djibril99/stageIRD/images/TEST_Filtre_mediant_passBas/provessus.jpg

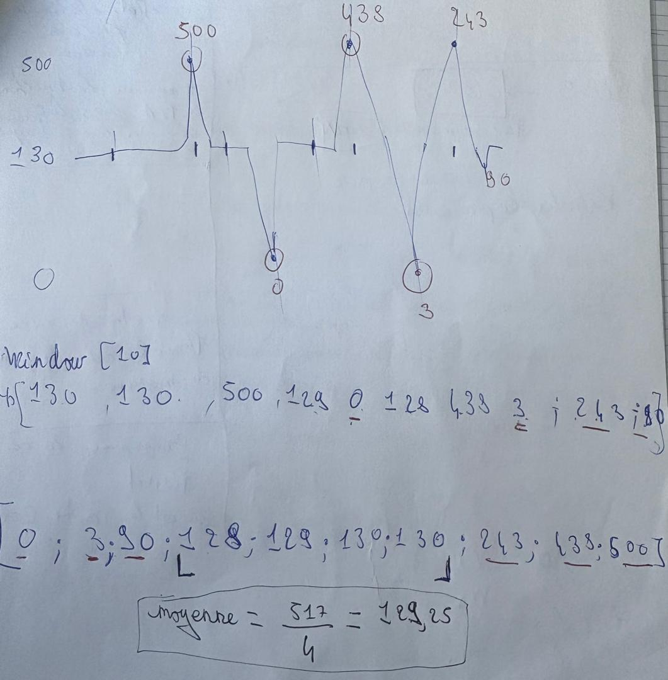
images/TEST_Filtre_mediant_passBas/provessus.jpg
