djibril99/stageIRD/images/capteur2.jpg

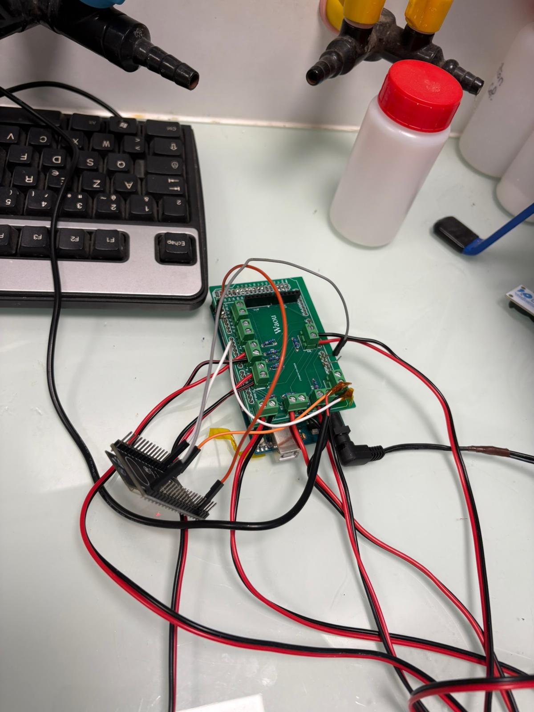
images/capteur2.jpg
