djibril99/stageIRD/Documents/version2026/Stage Djibril.pptx

Conception et etudes des sondes WAOU

## Slide 2

Plan
1. Contexte de l‘étude
2. Principe d’un Sonde résistif Waou
  A. Compositions de la sonde de mesure
  B. Dispositif électronique
  C. Limite de mesure du dispositif électronique
3. Fabrication des capteurs
  A. Conception du moule
  B. Impression des bouchons et moules
  C. Préparation du mélange (électrolyte poreux)
4. Validation des capteurs
  A. Séchage capteurs
  B. Mesures de 4 capteurs à des pF différentes
5. Bilan énergétique des capteurs (version 4.4)
  A. Puissance limite Utilisée
  B. Energie utilisée
  C. Bilan Energétique de la carte Méga 2560

## Slide 3

1. Contexte de l‘étude

Les types d’eau dans le sol

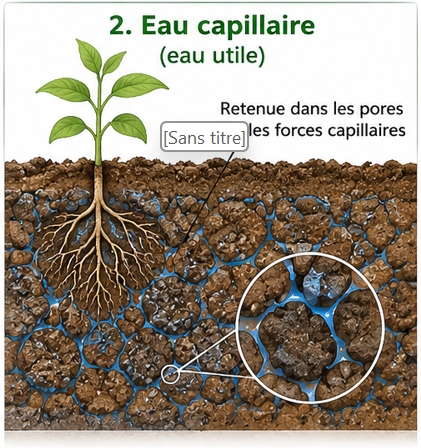
[picture p36: figure]

- Occupe les pores de taille moyenne.
- Retenue par les forces capillaires.
- Principale réserve d’eau utilisable par les plantes.
- Peut se déplacer dans le sol vers les racines.

Disponibilité pour les plantes ÉLEVÉE

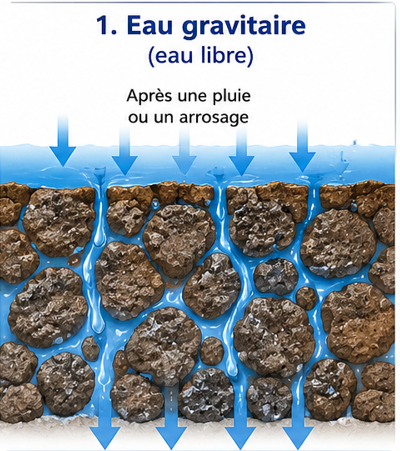
[picture p37: figure]

- S’écoule sous l’effet de la gravité.
- Peu disponible pour les plantes.
- Se draine rapidement après l’apport d’eau.

Disponibilité pour les plantes FAIBLE

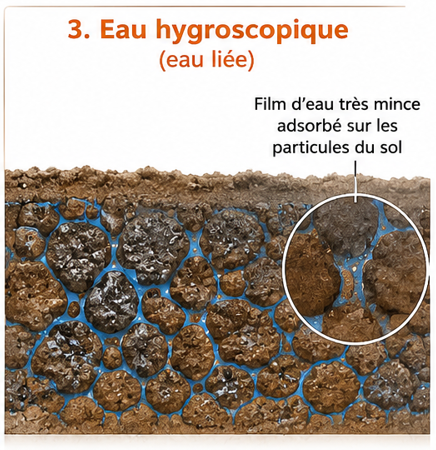
[picture p38: figure]

- Forme une fine pellicule autour des particules du sol.
- Très fortement retenue par les forces d’adsorption.
- Pratiquement non disponible pour les plantes.

Disponibilité pour les plantes NULLE

Peu disponible
(s'écoule vite)

Très disponible
(eau utile)

Non disponible
(eau liée)

## Slide 4

2. Principe d’un Sonde résistif Waou

## Slide 5

A. Compositions de la sonde de mesure

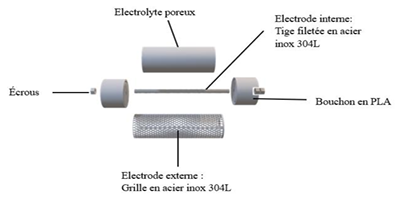
[picture p39: figure]
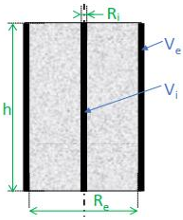
[picture p40: figure]

Électrode interne

Électrode Externe

Electrolyte poreux

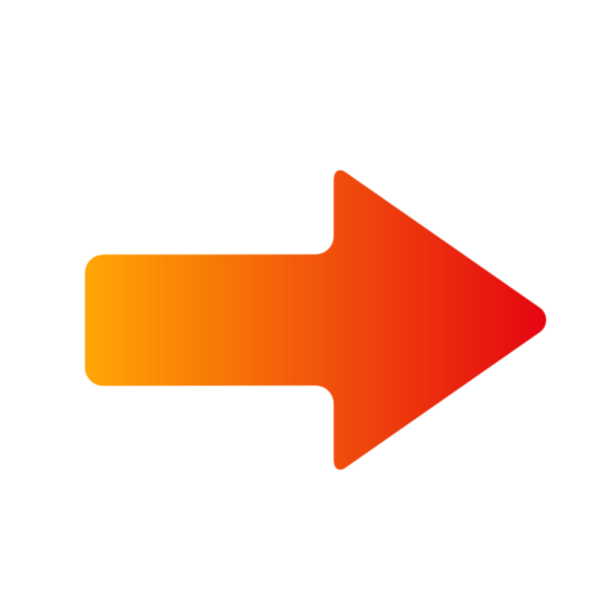
[picture p41: figure]
Red Arrow PNG Transparent Images Free Download - Pngfre

Résistance(R) du capteur

R(Ω)=(1/σ)(1/(2πh))ln((R_e)/(R_i))

D’un facteur géométrique

De la résistivité d’un matériau solide
ρ = 1/σ =%H2O

## Slide 6

B. Principe de Mesure

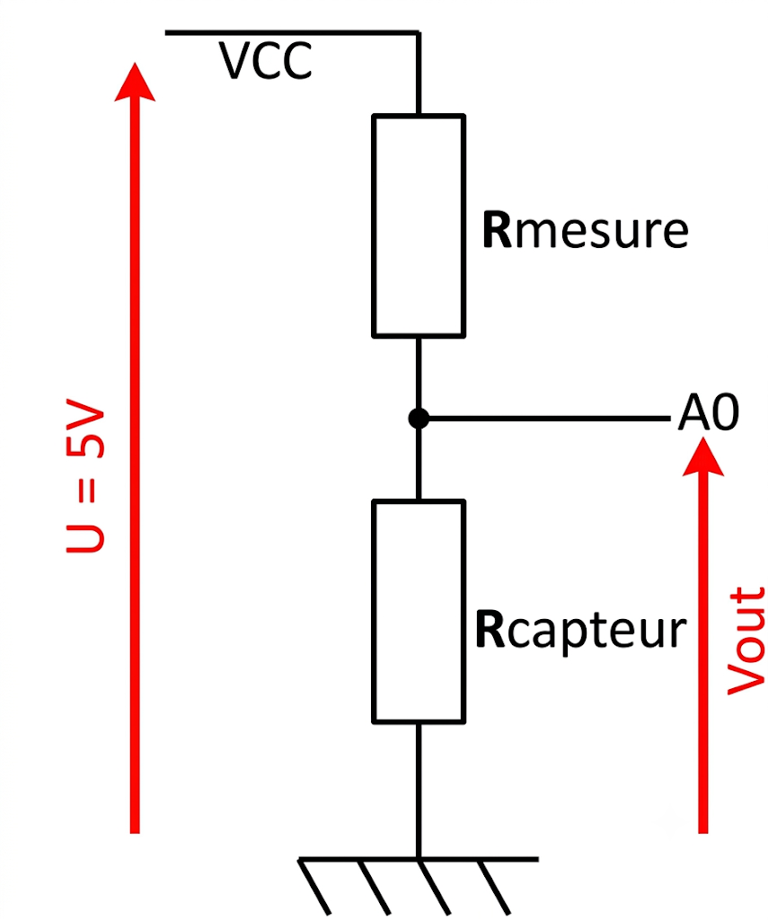
[picture p42: figure]

R_(cap) =R_(mes) ((V_(out))/(U−V_(out)))

R_(cap) =R_(mes) ((ADC)/(ADCmax−ADC))

Avec {, U=5 V, V_(out) ∈[0,5]V, ADC dépant de la carte utilisée , R_(mes) ≈99600 Ω

## Slide 7

B. Dispositif électronique

R_(cap) =R_(mes) ((V_(out))/(U−V_(out)))

Avec {, U=5 V, V_(out) ∈[0,5]V, ADC∈[0,1023], R_(mes) ≈99600 Ω

R_(cap) =R_(mes) ((ADC)/(ADCmax−ADC))

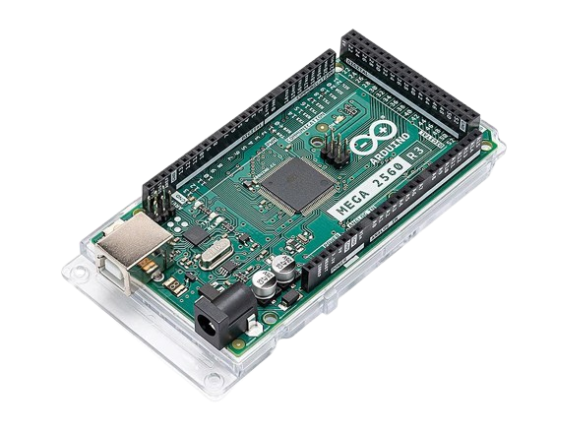
[picture p43: figure]

Arduino Mega 2560

Paramètre | Valeur
Microcontrôleur | ATmega2560
Tension de fonctionnement | 5 V
Résolution ADC | 10 bits (0 à 1023)
Nombre d'entrées analogiques | 16
Fréquence d'horloge | 16 MHz

## Slide 8

B. Dispositif électronique

a. Limites de mesures du système électronique (Atmega 2560)

R_(cap) =99600((ADC)/(1023−ADC))

Paramètre | Valeur
Microcontrôleur | ATmega2560
Tension de fonctionnement | 5 V
Résolution ADC | 10 bits (0 à 1023)
Nombre d'entrées analogiques | 16
Fréquence d'horloge | 16 MHz

ADC | Rcap (Ω)
0 | 0,00
1 | 97,46
2 | 195,11
3 | 292,95
4 | 390,98
5 | 489,20
509 | 98 630,50
510 | 99 017,61
511 | 99 406,23
512 | 99 796,88
513 | 100 189,57
1019 | 25 359 900
1020 | 33 864 000
1021 | 50 796 000
1022 | 101 803 200
1023 | ∞ (division par 0)

ADC DE 10bits (0 à 1023)

Limites de mesure

97.4Ω ≤ Rcapteur ≤ 101,8 MΩ

## Slide 9

B. Dispositif électronique

b. Incertitude de Mesure liée à l’ADC

- On calcule d’abord la plus petite valeur mesurable

Vmin =5/1024= 4.88 mV

ADC | Vmin (mV) | Vmax (mV)
0 | 0.00 | 4.88
1 | 4.88 | 9.76
2 | 9.76 | 14.64
3 | 14.64 | 19.52
…. | …. | ….
1013 | 4947.6 | 4952.5
1022 | 4991.3 | 4996.1
1023 | 4996.1 | 5000.0*

- Puis pour chaque digit (ADC) la plage de Resistance capteur mesurable

ADC | Rmin (Ω) | Rmax (Ω)
0 | 0 | 97.3
1 | 97.3 | 194.6
2 | 194.6 | 292
3 | 292 | 389
…. | …. | ….
1013 | 9.4 MΩ | 9.5 MΩ
1022 | 96 MΩ | 101 MΩ
1023 | 101 MΩ | ∞ (saturation)

Conclusion

Plus La tension du capteur approche 5 V , plus R devient Importante, plus incertitude explose

## Slide 10

B. Dispositif électronique

c. Validation de la carte de mesure et du code

- Le code du Waou V3 repris et adapté Pour nouveau dispositif mesure
- Résistance fixe de 475k ajoutée pour valider le circuit électronique

Parasites de mesures

Mesures résistance fixe 475Kohm +/- 5% en fonction du temps

Taux d'erreur Max :

((⃒PiqueResistanceMax−Reference⃒)/(Reference))∗100

((⃒473−475⃒)/475)∗100 = 0,42 %

## Slide 11

3. Fabrication des capteurs WAOU


## Slide 12


Aperçu du capteur V4.4

## Slide 13

3. Fabrication des capteurs WAOU

A faire plus tard:
expliquer la composition des capteurs , conception capteur ,
expliquer le modélisation 3D des moules , et principe d’utilisation de ces moules

## Slide 14

4. Validation capteur

## Slide 15

A. Séchage de Capteur

## Slide 16

A. Séchage des Capteurs

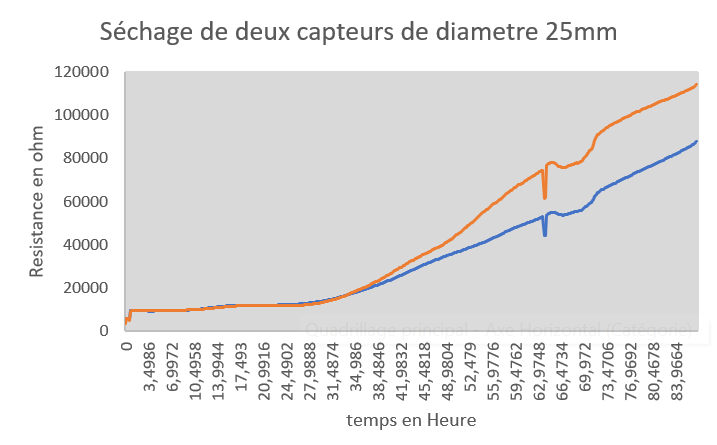
[picture p44: figure]

Séchage de deux capteurs en fonction du temps ( 84H)

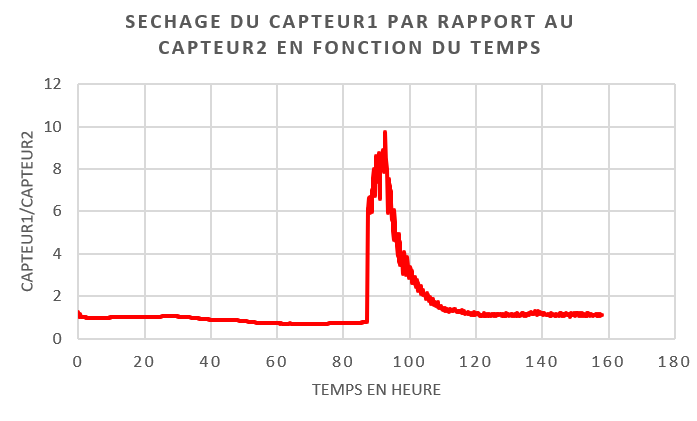
[picture p45: figure]

Evolution du capteur 1 PAR rapport au capteur 2 en 180H

- Le pic montre que le capteur 1 sèche plus rapidement que le capteur 2.
- Le retour vers la valeur initiale (après la pique) indique que le capteur 1 est complètement sec (A confirmer).
- Les deux capteurs tendent alors vers des valeurs proches lorsqu’ils sont secs.

## Slide 17

B. Mesures de 4 capteurs à des pF différentes

## Slide 18

B. Mesures de 4 capteurs à des pF différentes

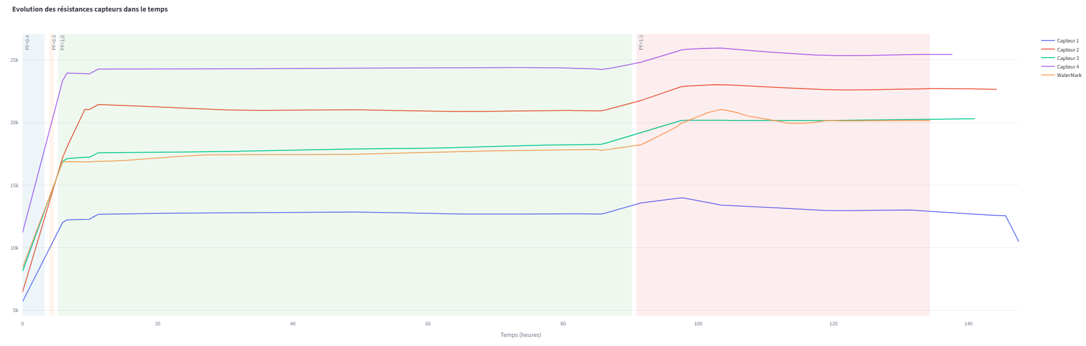
[picture p46: figure]

Variation de la Resistance des capteurs en fonction du pF et du temps

pF = log( pression(mbaR) )

- Mesures sur 4 capteurs et comparaison avec un Watermark (WM) et un tensiomètre.
- Tests réalisés pour différents pF.
- Les quatre capteurs présentent des courbes de même allure.
- Le Watermark et le capteur 4 ont été testés dans les mêmes conditions.
- Tensiomètre installé : plage de mesure 0 à 40 kPa (avec 1 kPa = 10 mbar).


## Slide 19

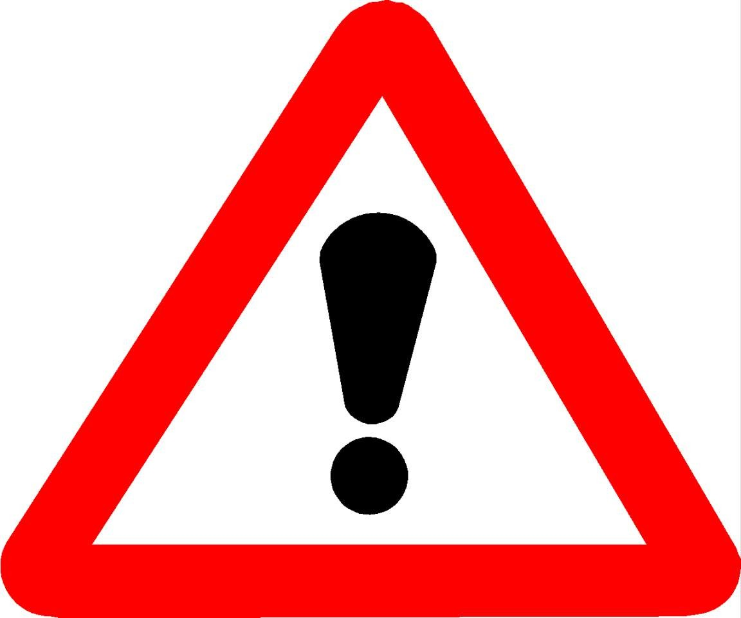
[picture p47: figure]
panneau attention clipart 10 free Cliparts | Download images on ...

Les mesures peuvent être affectées par du bruit (chutes de tension, perturbations électriques/électroniques, etc.).


Référence
825kΩ

Watermark
⌉5kΩ;20kΩ⌈

Capteur3
⌉7kΩ;22kΩ⌈

Capteur2
⌉4kΩ;18kΩ⌈


bruit de mesure

## Slide 20

B. Mesures de 4 capteurs à des pF différentes

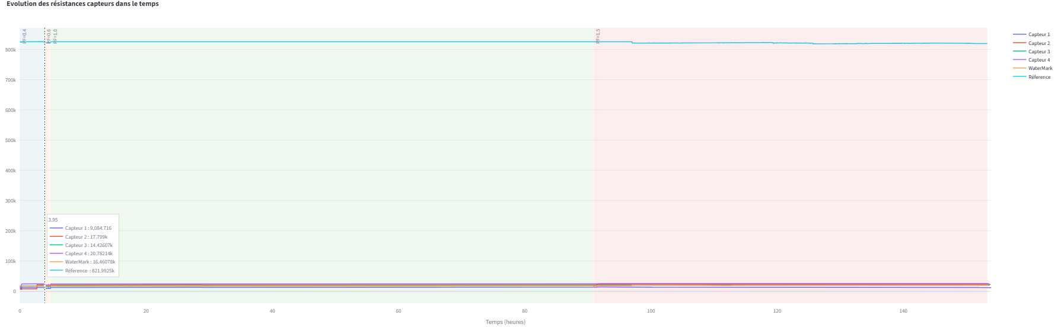
[picture p48: figure]

Une référence (résistance fixe) est ajoutée afin de valider la conformité des données mesurées et
de détecter les chutes de tension ainsi que le bruit de mesure.

## Slide 21

5. Bilan énergétique des capteurs (version 4.4)

## Slide 22

A. Puissance limite Utilisée


Puissance d’un capteur en fonction de la resistance capteur

Avec Rcap≈0;....;101.8 MΩ

Conclusion:
Plus le milieu est humide, plus la puissance utilisée est importante, plus la consommation énergétique devient importante aussi

## Slide 23

B. Energie utilisée

L’énergie consommée est donnée par la relation :
E(j) = P(w) × t(s)

  - Pour huit capteurs :
E = 8 × 130 ≈ 1042 μJ
  - Une mesure est effectuée toutes les heures :
T = 3600 s

La puissance maximale d’un capteur est de :
P = 25.25 μW
  - Pour une acquisition de donnée:
T = 10 ms
E = 25.25 × 0.01 ≈ 0.2525 μj
  - Pour 5OO acquisitions de donnée:
T = 5.161 s
E = 25.25 × 5.161 ≈ 130 μj

Pmoy = E(j)/T(s)
Pmoy≈ 0.290 μW

## Slide 24


t = 3600 s
P = 0.095 *5V = 0,475W
E = 0,475× 3600 ≈ 1710j

C. Bilan Energétique de la carte Méga 2560


La consommation de la carte est nettement supérieure à celle utilisée par les capteurs.

1710j >>>1042 μJ


1710 J est environ 1,64 million de fois plus grand que 1042 µJ

## Slide 25

A SUIVRE!!!!
S’arrêter sur ce slide

## Slide 26

## Slide 27

## Slide 28

- Validation de la carte de mesure et du code

Tu as nettoyé le code et implémenté sur une nouvelle carte

Parasites de mesures

  - Traduir en delta ADC
  - Faire mesure sur d’autre avaleur de resistances

Bruit électronique :
Mesure résistance fixe 475Kohm +/- 5% en fonction du temps

Taux d'erreur Max:


≈ 0,42 %

## Slide 29

SONDE RESISTIVE WAOU


Avec Rmes≈99600 Ω

Schéma capteur
Parler de la carte
Puis du principe de mesure

## Slide 30

  - Traitement du signal


Parasites de mesures

Estimation de la valeur de la référence

Quelle Valeur tu lis
variation de la resistance de mesure Fixe

Technique utilisée:

Pour supprimer les pics aberrants.

  - Filtre EMA (Exponential Moving Average)

  - un Filtre médian

Avantage

  - Augmente la précision des données
  - Reduit le nombre de lecture (de 500 à 70 )
  - Reduit la consommation énergétique
  - temps de lecture qui passe de 5,1s à 700ms

Taux d'erreur Max:


0,02105%

## Slide 31

Solution

Parasites de mesures

variation de la resistance de mesure Fixe

Faire une estimation de la valeur de la référence

Quelle solution tu prends pour lisser dans le code ou en post-traitement????

## Slide 32

Fabrication des capteurs

protocole / photos /changement proportion du mélange

## Slide 33

Séchage de Capteur

## Slide 34


Référence de 475K ohms

Séchage de deux capteurs pendant 3 jours ++++++

## Slide 35

METTRE DES ZOOMS !!!!!!
Calculer la difference / rapport entre les 2 courbes
4k =dans l’eau?

La résistance des capteurs évolue de 4 kΩ à l'état humide jusqu'à 75 kΩ après 60 heures de séchage.


## Slide 36

Résultats des mesures dans une table à succion

## Slide 37

Mesure sur 4 capteurs et comparaison d’autres méthodes WM et tensiomètre
On test different pF seul le pF1 est valide
Coubre de meme allures pour les 4 capteurs
On compare les résiatance donner les resistances tablea avec Rcapt pour pF1 idebtifier sur photo
  - Watermark et capteur 4 dans les mêmes conditions et dans la même gamme de mesure.
  - irromètre Installé (0kPa ; 40 kPa) avec 1kPa = 10mbar

Refaire le graph avec les bonnes legends capteur WAOUXXX… WM et donner les valeurs du tensiomètre
Conclure…

Variation de la Resistance des capteurs en fonction du pF et du temps

pF=log10(mbaR)

## Slide 38

La mesure de la resistance permet d’identifier de pb de mesure : saut de potential … en plus du bruit


Référence

WaterMark

Référence

  - Référence de 825000 ohms
  - Watermark à la position 8

## Slide 39

Référence
825kΩ

Watermark
⌉5kΩ;20kΩ⌈

Capteur4
⌉7kΩ;22kΩ⌈

Capteur2
⌉4kΩ;18kΩ⌈

Dans le même bêcher

bruit de mesure

## Slide 40

Mettre les courbes de mesure des capteurs dans la table

## Slide 41

Consommation énergétique

## Slide 42

Puissance

Milieu humide

Rcap→0

Milieu sec

Rcap→∞

Gamme de resistance des capteurs :
1kohm à 1méga


Puissance max par capteur
pour une lecture

## Slide 43

Puissance limite

## Slide 44

0;....;101.8 MΩ

Puissance d’un capteur en fonction de la resistance capteur

P(w)

pF(mbar)

Puissance d’un capteur en fonction du pF

Rcap≈

## Slide 45

Bilan Energétique des capteurs

  - Pour huit capteurs :
E = 8 × 130 ≈ 1042 μJ
  - Une mesure est effectuée toutes les heures :
T = 3600 s

L´énergie consommée est donnée par :
E(j) = P(w) × t(s)

La puissance d’un capteur est de :
P = 25.25 μW
  - Pour une acquisition de donnée:
T = 10 ms
E = 25.25 × 0.01 ≈ 0.2525 μj
  - Pour 5OO acquisitions de donnée:
T = 5.161 s
E = 25.25 × 5.161 ≈ 130 μj

Pmoy = E(j)/T(s)
≈ 0.290 μW

## Slide 46

t = 3600 s
P = 0.095 *5V = 0,475W
E = 0,475× 3600 ≈ 1710j

Bilan Energétique de la carte Méga 2560

La consommation de la carte est nettement supérieure à celle utilisée par les capteurs.

1710j >>>1042 μJ

1710 J est environ 1,64 million de fois plus grand que 1042 µJ

## Slide 47

1. Contexte de l‘étude
