djibril99/stageIRD/donneeCapteur/cloneSDMrhallez/readme.txt

ces donnees viennent du capteur qui a été implenté chez monsieur halez .
elles sont issues de la version du qameleo avec un relais , gsm , sd ....
