djibril99/stageIRD/Documents/version2026/TEMPLATE_RAPPORT_2026.docx

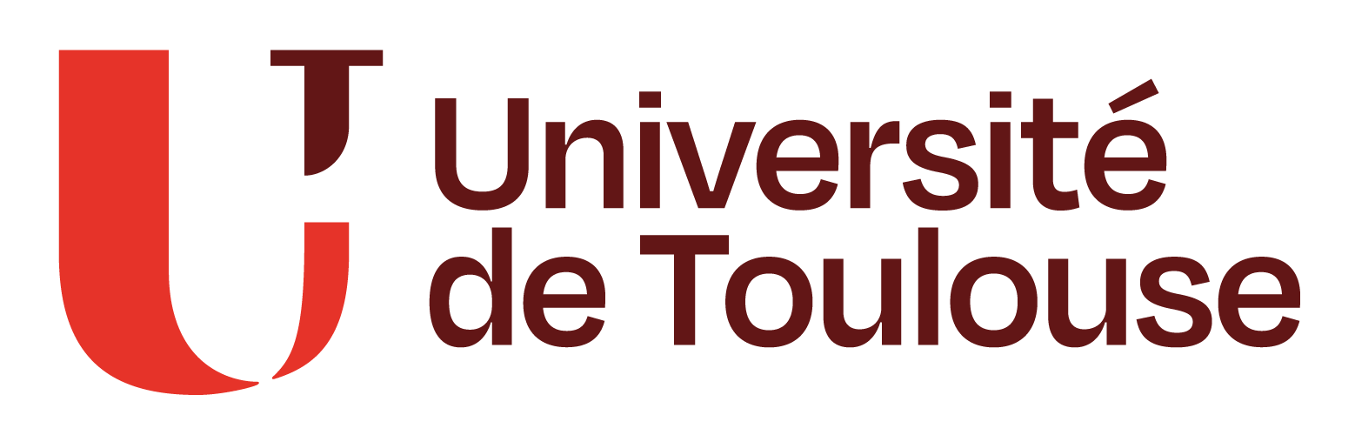
[picture p49: figure]
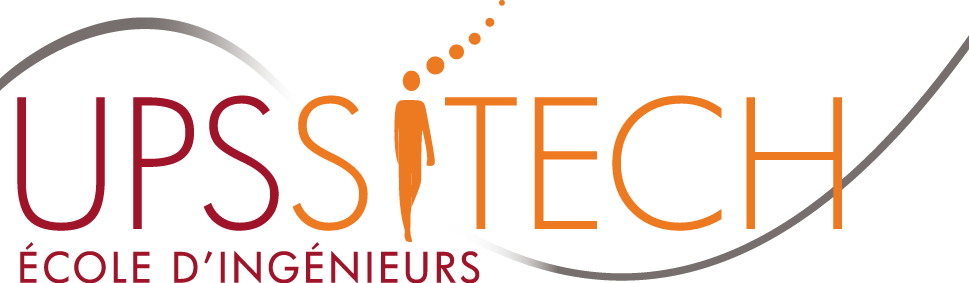
[picture p50: figure]
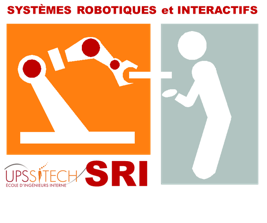
[picture p51: figure]
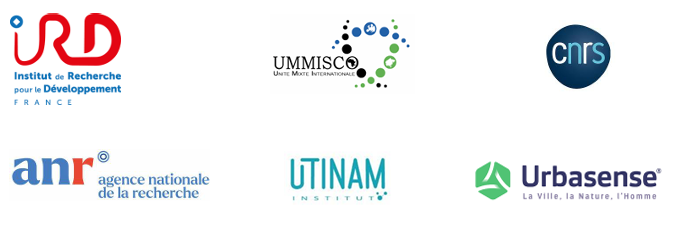
[picture p52: figure]

Rapport de stage

Industrialisation du capteur WAOU, finalisation du prototypage, développement hardware

Effectué par M. Ba Djibril

Du 20 Avril 2026 au 21 Aout 2026

Tuteur de stage : M. Nicolas Marilleau et M. Loic Hallez

Superviseur académique : M.Nicolas Rivière

Établissement : Université de Toulouse – Diplôme préparé 4ème cycle ingénieur UPSSITECH – Spécialité SRI (2025-2026)

Entreprise d’accueil : IRD (Institut de Recherche pour le Développement) de Bondy

Résumé (1/2 page ou 2 pages si rapport en anglais)

Abstract (1/2 page)

SOMMAIRE

# Introduction

Face aux défis climatiques, la technologie se met à l'écoute de la nature. Grâce à l’informatique embarquée et à des capteurs d'humidité et de température, il est désormais possible de mesurer en temps réel les besoins vitaux de la végétation. Cette alliance entre numérique et environnement permet une gestion plus précise et durable de nos écosystèmes.

C’est dans ce contexte que j’ai effectué mon stage de 4ème année d’une durée de 18 semaines, du 20 avril au 21 août 2026. Ce stage s'est déroulé à l’Institut UTINAM de Besançon, dans le cadre du projet WAQATALI, financé par l’Institut de Recherche pour le Développement (IRD) de Bondy.

L’Institut UTINAM est un laboratoire de recherche académique pluridisciplinaire spécialisé en physique et en chimie. Durant cette expérience, j'ai été encadré par M. Nicolas Marilleau et M. Loïc Hallez.

Au cours de ce stage, ma mission principale a été le prototypage, la conception des dernières versions du capteur mais aussi le développement software et Hardware .

La problématique générale du projet consiste à concevoir un système à la fois robuste, fiable et autonome pour le milieu naturel. Ma contribution principale, développée dans ce rapport, porte sur le prototypage de la dernière version du capteur WAOU, le développement Software pour l’extraction et le traitement des données, ainsi que l'optimisation Hardware du dispositif.

Pour rendre compte de ce travail, ce rapport est organisé en trois sections, dans la première section je vous ferais une présentation détaillée de l'organisme d'accueil et du contexte du projet. Ensuite je poursuivrais dans une deuxième section sur l’étude technique, choix des composants et conception du capteur afin de terminer par une troisième section où les Résultats obtenus, tests réalisés seront présentés.

# Environnement du stage (1 à 2 pages max)

Mode de fonctionnement (fréquences réunions, autonomie…) et de gestion de projets (méthodes agiles…), outils de gestion de projets...

## 1.1. Le projet WAQATALI :

Le projet WAQATALI, acronyme de Water & Air QuAlity Monitoring for Smart VegeTAL Infrastructures in Cities, s'inscrit dans la nécessaire transition des milieux urbains vers des modèles plus durables et résilients face aux défis climatiques, environnementaux et sociétaux.

C'est dans ce contexte qu'a été lancé ce Laboratoire Commun (LabCom), cofinancé par l'Agence Nationale de la Recherche (ANR) à hauteur de 362 999 € pour une durée de cinq ans.

Ce projet collaboratif est porté par un partenariat stratégique entre l'entreprise UrbaSense, spécialisée dans le pilotage de l'arrosage connecté, et l'Unité Mixte Internationale UMMISCO (Unité de Modélisation Mathématique et Informatique des Systèmes Complexes) de l'IRD (Institut de Recherche pour le Développement). Fortement pluridisciplinaire, il fédère également l'expertise de plusieurs autres laboratoires de recherche spécialisés en informatique, chimie, pédologie, géographie et climatologie.

L'ambition principale de WAQATALI est de soutenir le développement de villes durables en favorisant la végétalisation des espaces urbains. Au-delà de leur aspect esthétique, ces infrastructures végétales visent à améliorer la qualité de l'air, réduire les îlots de chaleur urbains, optimiser la gestion de la ressource en eau et renforcer la biodiversité. Fidèle à une philosophie écoresponsable, le projet privilégie le développement de solutions à faible coût (low cost) conçues à partir de matériaux biosourcés et biodégradables afin de minimiser leur empreinte environnementale globale.

Pour structurer ses recherches, les activités du LabCom s'articulent autour de six axes d'innovation complémentaires :

- Axe 0 : Coordination et valorisation du projet.
- Axe 1 : Stratégies d'irrigation déficitaire.
- Axe 2 : Classification multicritères des espaces végétalisés.
- Axe 3 : Construction d'un indicateur global d'efficacité des infrastructures végétalisées.
- Axe 4 : Développement et production de matériel dédié aux mesures.
- Axe 5 : Modélisation participative pour l'aide à la décision.

Mon stage s'intègre directement au cœur de l'axe 4 de ce programme de recherche. Ma mission consiste plus précisément à concevoir, développer et valider un système de mesure destiné au suivi précis de l'humidité des sols. L'enjeu majeur de ce travail est de s'appuyer sur des capteurs à faible coût capables de fournir des mesures hautement fiables, tout en répondant aux contraintes strictes de déploiement opérationnel sur des infrastructures végétalisées en milieu urbain.

# Problématique du stage

## 1.2. Problématique et Contexte Scientifique

### Physique de l'eau dans le sol et sa disponibilité pour les plantes :

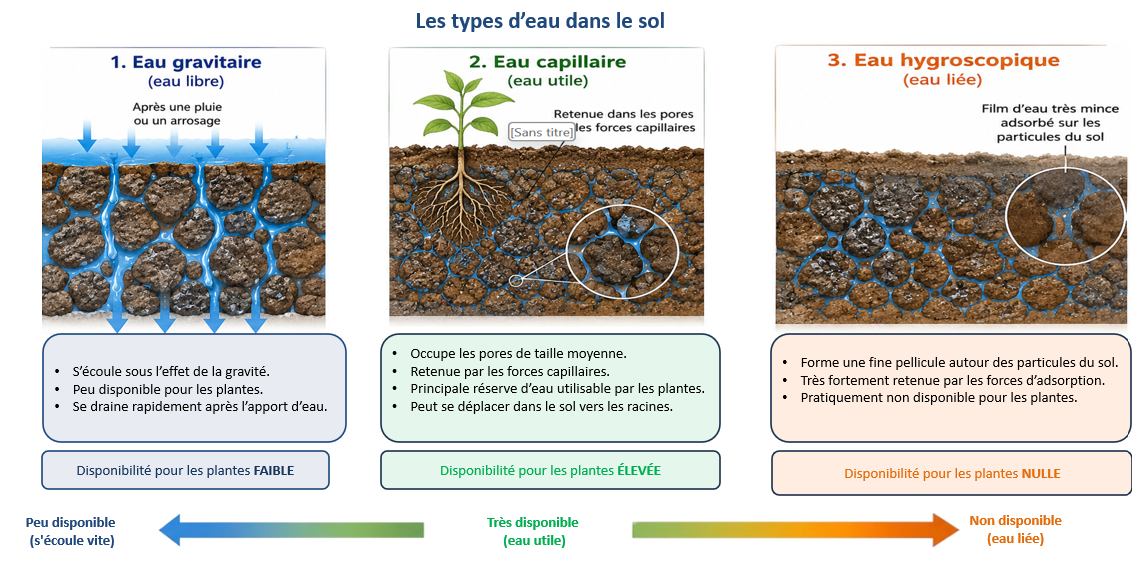
[picture p53: figure]

TITRE FIGURE

L'eau présente dans le sol se divise en plusieurs catégories selon sa difficulté à être extraite du sol par les plantes (Figure 2). Pour bien comprendre ces différents états et savoir quand irriguer, voyons comment se comporte l'eau juste après une pluie :

### L’eau gravitaire (ou eau libre) – Juste après la pluie

Lors d'une pluie intense ou d'un arrosage abondant, les pores du sol se saturent temporairement. Soumise principalement à la force de gravité, cette eau gravitaire s'infiltre et s'écoule rapidement vers les couches profondes. Les liaisons avec le substrat étant extrêmement faibles, son transit ne dure que très peu de temps (quelques heures à quelques jours). En raison de ce drainage rapide, sa disponibilité pour les plantes est faible.

### L’eau capillaire (ou eau utile) – Quelques heures à quelques jours après la pluie

Une fois l'excès d'eau évacué par gravité, le sol atteint sa capacité au champ. L'eau restante est piégée dans les pores moyens (0,2 à 10 μm ) par des forces de capillarité et de tension superficielle, formant des ménisques entre les grains du sol. Cette eau capillaire résiste à la gravité tout en demeurant facilement mobilisable par la suceuse des racines. Elle constitue la principale réserve en eau disponible (eau utile) pour la nutrition et la croissance des végétaux.

### L’eau hygroscopique (ou eau liée) – En période de sécheresse prolongée

Lorsque le sol s'assèche, il ne reste qu'un film d'eau très mince adsorbé à la surface des particules minérales. Retenue par de très fortes forces d'attraction moléculaire, cette eau hygroscopique est physiquement inatteignable par les racines. Pour réussir à l'extraire, la plante devrait exercer une pression de succion supérieure au point de flétrissement permanent. À ce stade, la disponibilité est nulle et la plante dépérit.

### Définition des termes généraux

#### 1.2.1.1. Potentiel hydrique

Le potentiel hydrique peut être défini comme la force avec laquelle le sol retient l'eau.

Il se calcule à partir de la formule :

pF=log_10 (P)

Où P représente la pression de succion du sol exprimée en mbar.

Autrement dit, il s'agit de la force nécessaire pour extraire l'eau du sol. Cette pression est mesurée sur le terrain à l'aide d'un irromètre (un instrument mécanique dédié à la mesure de cette force de succion).

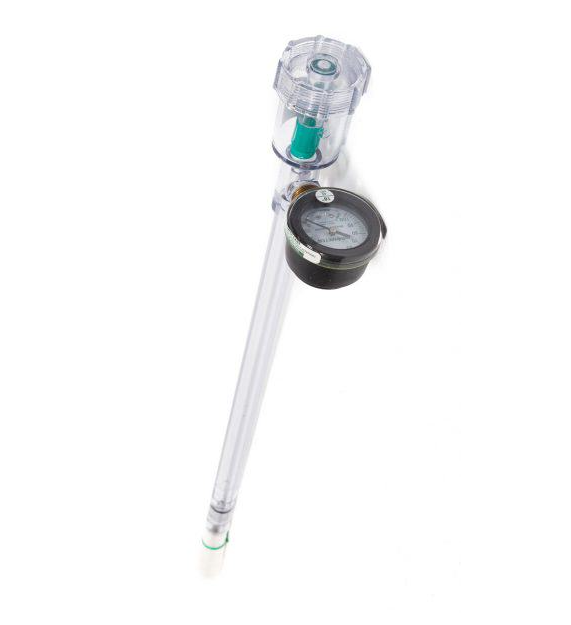
[picture p54: figure]

Titre

Comme il s'agit d'une relation logarithmique, une augmentation de la pression mesurée par l'irromètre se traduit par une hausse de l'indice pF (chaque augmentation d'une unité de pF correspond à une pression 10 fois plus forte).

Tension d'humidité du sol
Valeur pF | Pression ( mbar )
0,0 | - 1,0
0,4 | - 2,5
1,0 | - 10,0
1,5 | - 31,6
1,8 | - 63,1
2,0 | - 100,0

TITRE tableau

### Principe d’un Sonde résistif Waou

#### 1.2.1.2. Historique des sondes Waou :

#### 1.2.1.3. Composition et structure de la sonde de Mesure :

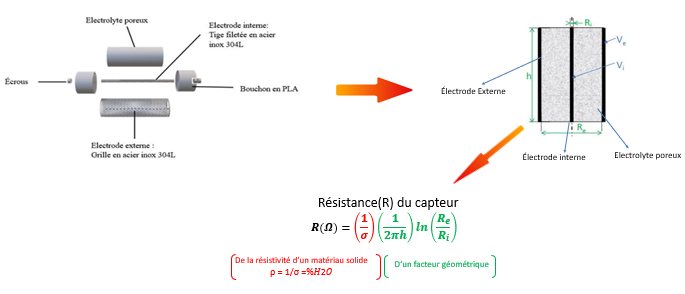
[picture p55: figure]

Titre

Le capteur est composé de deux électrodes : une électrode centrale sous forme de tige filetée et une électrode externe constituée d’une grille cylindrique. Les deux éléments sont fabriqués en acier inoxydable 304L afin d’assurer une haute résistance à la corrosion et d’éviter tout phénomène de couplage galvanique (effet pile) pouvant perturber les mesures ou dégrader prématurément le système. La tige est fixée au centre du bouchon par un assemblage d’écrous et d’écrous-freins, tandis que la grille, soudée sur sa longueur pour former un cylindre, est insérée dans l’entaille du bouchon.

Sur le plan géométrique, la matrice de mesure est caractérisée par :

- Un rayon externe ( R_e ), correspondant au rayon de la grille cylindrique,
- Un rayon interne ( R_i ), correspondant au rayon de la tige centrale,
- Une hauteur ( H ), représentant la hauteur utile d'interaction entre les deux électrodes.

Entre ces deux électrodes se trouve un électrolyte constitué d'un mélange chimique spécifique (détaillé dans la section XX).

Cette matrice poreuse agit à la manière d'une éponge : une fois immergée dans le sol, elle absorbe ou libère de l'eau jusqu'à atteindre un équilibre capillaire avec le milieu environnant (le transfert d'eau s'effectue naturellement de la zone la plus humide vers la moins dense).

La résistance électrique de cet électrolyte varie directement en fonction de sa teneur en eau ( %H_2 O , représenté par la proportion d'eau retenue dans les pores) : plus le milieu est sec, plus la résistance ( R ) de la matrice augmente. En connaissant les dimensions géométriques du capteur ( R_e ,R_i ,H ) ainsi que la quantité d'eau retenue ( ρ) , la résistance équivalente de l'électrolyte peut être modélisée analytiquement par la formule suivante :

R(ohm)=ρ/(2πH)ln((R_e)/(R_i))

Enfin, des fils de liaison reliés aux deux électrodes permettent de raccorder l'ensemble à la carte d'acquisition électronique (Microcontrôleur).

  2.1 Approche, Travaux et Contraintes Techniques
    2.1.1 Situation initial (prototypes labo) et modernisation des capteurs

# État de l’art et/ou étude de l’existant

Dans une méthodologie scientifique, il est nécessaire de faire le point sur les approches déjà utilisées pour traiter le même problème, ou un problème similaire, les mêmes données ou des données similaires… Il est nécessaire de faire un point sur l’existant en termes de méthodes, de données, de modèles… et/ou de dispositifs, logiciels déjà existants et qui vous ont permis d’aborder la question scientifique et/ou technique qui vous a été soumise.

Ceci doit s’appuyer sur des références bibliographiques (articles scientifiques, sources vérifiées) et/ou des éléments issus du web (tutoriels, site web, doc en ligne…). Ces éléments doivent être référencés dans le texte et dans la section dédiée Bibliographie/Webographie (en note bas de page pour les sites web/GitHub, par exemple). L’idée est de positionner votre travail par rapport à ces éléments scientifiques existants.

= en gros… vous avez voulu appliquer ces méthodes ou bien les faire évoluer, les adapter, les appliquer à d’autres données, en proposer une différente… il faut expliquer sur quoi vous vous êtes appuyé pour la suite de votre travail et pourquoi, cela permettra aussi de justifier les choix de matériel, de techno, d’approches...

Parler de document qui existe déjà , rapport de satges, fichier excel pour calculer les poucentage de matier a introduire dans le capyeur ,

# Implémentation de votre solution/approche

## 1.3. Principe de mesure de la sonde

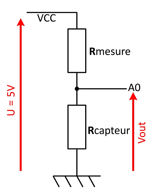
[picture p56: figure]

Titre Image

Pour mesurer la résistance aux bornes du capteur ( R_(capteur) ), on se base sur le principe du pont diviseur de tension. En associant le capteur en série avec une résistance connue de référence ( R_(mesure) ), on applique une tension d'entrée V_(in) (ou U ) au montage et on mesure la tension V_(out) aux bornes du capteur.

La tension de sortie V_(out) s'exprime selon la relation :

V_(out) =V_(in) ⋅(R_(capteur))/(R_(mesure) +R_(capteur))

En isolant la résistance du capteur R_(capteur) , on obtient la formule pratique d'extraction :

R_(capteur) =R_(mesure) ⋅(V_(out))/(V_(in) -V_(out))

## 1.4. Dispositif électronique :

Pour acquérir les données du capteur, n'importe quel microcontrôleur peut être utilisé à condition qu'il soit équipé d'un convertisseur analogique-numérique (ADC) capable de mesurer la tension aux bornes du capteur. L'intégration d'un ADC externe à haute résolution est également envisageable si une précision de mesure supérieure est requise.

Dans le cadre de notre étude, nous utiliserons le microcontrôleur ATmega2560, choisi pour ses caractéristiques techniques adaptées aux contraintes du système.

### Caractéristiques du microcontrôleur (ATmega2560) :


TITRE

Paramètre | Valeur
Microcontrôleur | ATmega2560
Tension de fonctionnement | 5 V
Résolution ADC | 10 bits (0 à 1023)
Nombre d'entrées analogiques | 16
Fréquence d'horloge | 16 MHz

TITRE

Parmi les caractéristiques de l'ATmega2560 présentées dans le tableau ci-dessus, les éléments les plus critiques pour notre étude sont la tension de fonctionnement ainsi que la tension d'alimentation des capteurs, toutes deux à 5 V .

De plus, le microcontrôleur dispose de 16 entrées analogiques, ce qui permet théoriquement d'acquérir les données de 16 sondes. Toutefois, dans le cadre de nos essais en laboratoire, le nombre de capteurs sera limité à 8 unités utilisées.

L'ATmega2560 est équipé d'un convertisseur analogique-numérique (ADC) d'une résolution de 10 bits, ce qui signifie que la plage de tension de 0 à 5 V est quantifiée sur 2^10 =1024 pas (valeurs de 0 à 1023 ).

La tension de sortie V_(out) mesurée s'exprime ainsi en fonction de la valeur brute renvoyée par l'ADC ( ADC_(val) ) :

V_(out) =(ADC_(val) *5)/1023

En substituant cette expression de V_(out) dans la formule initiale du pont diviseur de tension, on obtient la relation directe entre la résistance du capteur R_(cap) et la valeur numérique lue par l'ADC :

R_(cap) =R_(mesure) ⋅(ADC_(val))/(1023-ADC_(val))

### Limites de mesure du système électronique :

Étant donné que notre convertisseur (ADC) possède une résolution de 10 bits ( 1024 niveaux discrets, indexés de 0 à 1023 ), il est possible de calculer la valeur de la résistance R_(capteur) associée à chaque pas de mesure.

On observe toutefois des sauts de valeurs. Autrement dit, pour une plage donnée de résistances proches les unes des autres, le microcontrôleur renverra la même valeur numérique (le même digit).

Par exemple :

- Pour toute valeur de R_(capteur) comprise entre 0 Ω et 97,46 Ω , l'ADC renverra la valeur 0 .
- Ce phénomène de perte de résolution s'accentue fortement lorsque la valeur de l'ADC approche des limites hautes. À titre d'illustration, pour toute valeur de résistance comprise entre 50 796 000 Ω et 101 803 200 Ω , l'ADC renvoie la même valeur fixe de 1021 , soit un écart considérable (51 007 200 valeurs) partagé par un seul et même code numérique.

ADC | Rcap (Ω)
0 | 0,00
1 | 97,46
2 | 195,11
3 | 292,95
4 | 390,98
……………. | …………
510 | 99 017,61
511 | 99 406,23
512 | 99 796,88
513 | 100 189,57
……………. | …………….
1020 | 33 864 000
1021 | 50 796 000
1022 | 101 803 200
1023 | ∞ (division par 0)

Titre Tableau

Cette limite de précision sera analysée en détail dans la section suivante.

#### 1.4.1.1. Incertitudes de mesure liées à l’ADC

Pour déterminer le pas de résolution de notre ADC, on divise la tension maximale mesurable ( V_(CC) =5 V ) par le nombre total de pas de quantification. L'ADC possédant une résolution de 10 bits ( 2^10 =1024 pas), la plus petite variation de tension détectable, notée V_(min) , est définie par :

V_(min) =(V_(max))/1024=(5 V)/1024≈4,88 mV

Cette valeur permet de déterminer la plage de tension associée à chaque code numérique (digit) renvoyé (Tableau 1). En appliquant la formule du pont diviseur de tension établie précédemment, il devient possible de calculer la plage de résistance correspondante pour chaque digit (Tableau 2).

Afin d'analyser l'évolution de cette incertitude sur l'ensemble de la plage de mesure, un troisième tableau (Tableau 3) présente, pour chaque digit, la plage d'incertitude en ohms (correspondant à la résolution spatiale du capteur). Cette valeur est obtenue en calculant la différence entre la résistance maximale et la résistance minimale associées à un même digit :

ΔR_(cap) =R_(cap, max) -R_(cap, min)

ADC | Vmin (mV) | Vmax (mV)
0 | 0.00 | 4.88
1 | 4.88 | 9.76
2 | 9.76 | 14.64
3 | 14.64 | 19.52
…. | …. | ….
1013 | 4947.6 | 4952.5
1022 | 4991.3 | 4996.1
1023 | 4996.1 | 5000.0

ADC | Rmin (Ω) | Rmax (Ω)
0 | 0 | 97.3
1 | 97.3 | 194.6
2 | 194.6 | 292
3 | 292 | 389
…. | …. | ….
1013 | 9.4 MΩ | 9.5 MΩ
1022 | 96 MΩ | 101 MΩ
1023 | 101 MΩ | ∞ (saturation)

Titre Tableau Titre Tableau

D'après cette courbe, on voit nettement que le pas de résolution (c'est-à-dire l'écart de résistance associé à chaque digit) augmente à mesure que la valeur de l'ADC s'élève. Cela signifie que plus le milieu dans lequel se trouvent les capteurs est sec, plus l'imprécision sur la lecture devient importante.

En effet, la valeur de l'ADC se rapproche de 1023 lorsque le capteur se trouve dans un sol sec ou lorsqu'il est débranché. Autrement dit, plus le pF du milieu augmente (caractérisant un sol sec), plus l'incertitude sur la mesure s'accroît, car la résolution se dégrade directement avec la montée de l'ADC.

## 1.5. Mise en place du système de mesure :

La lecture des données repose sur le principe du pont diviseur de tension évoqué précédemment. Les broches V_(CC) et GND de ce circuit sont branchées sur les pins numériques du microcontrôleur. Cela permet de ne pas polariser le capteur en continu et de ne l'activer qu'au moment exact de la mesure.

Afin d'éviter la corrosion accélérée des électrodes et de ne pas altérer le milieu, les acquisitions sont effectuées en courant pseudo-alternatif grâce à une inversion de polarité à chaque mesure. Lors d'une phase inversée, la tension aux bornes de la résistance du capteur se calcule par la formule :

U_(capteur) =V_(CC) -V_(out)

Soit en valeur numérique :

ADC_(capteur) =ADC_(max) -ADC_(mesuré)

(Où ADC_(max) =1023 pour un Arduino méga 2560).

Enfin, les expériences menées les années précédentes (Rapport Poline Jacquemene, 2025) ont démontré qu'une bonne lecture nécessite d'effectuer une série acquisitions (700 pour notre cas). La moyenne arithmétique de ces valeurs calculées est ensuite renvoyée, ce qui permet de minimiser les parasites environnementaux (variations de pH, bruits électromagnétiques).

## 1.6. Fabrication des sondes WAOU

# Résultats obtenus, analyse et discussion

## 1.7. Validation du système de mesure

Afin de valider le bon fonctionnement du système d'acquisition, une résistance fixe de 475 kΩ a été branchée à la place du capteur. Le choix de cette valeur est arbitraire ; l'intérêt réside dans le fait que la résistance étant théoriquement constante, il devient aisé de vérifier la fidélité et la stabilité de la mesure.

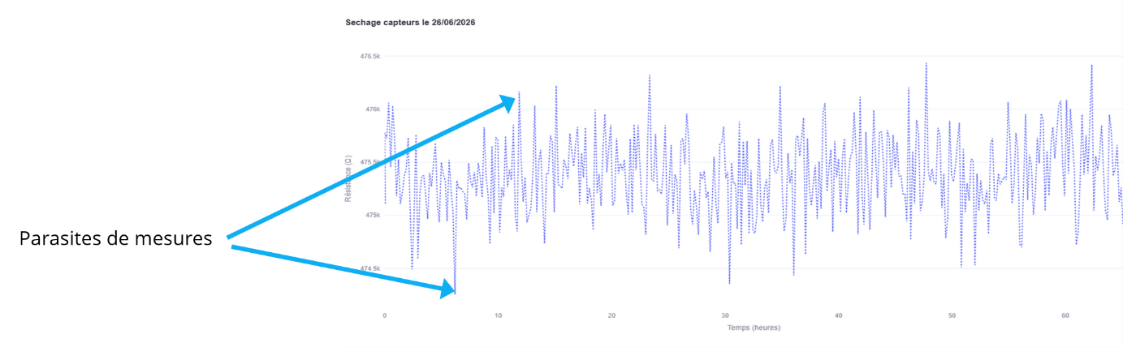
[picture p57: figure]

Le graphique ci-dessus illustre la variation de la résistance mesurée sur une durée de 60 heures, avec une fréquence d'acquisition d'une mesure par heure (3600 secondes).

Pour de futurs tests de validation plus rapides, cette période d'échantillonnage pourra être réduite à quelques secondes.

À l'observation de la courbe, les valeurs relevées ne sont pas strictement constantes et présentent un léger bruit de mesure ainsi que de faibles pics ponctuels (parasites). La valeur mesurée s'exprime ainsi sous la forme :

Valeur_(mesurée) =Valeur_(réelle) +Bruit

Je vous propose de faire une petite étude sur cette erreur liée à cette expérience : pour essayer d’y apporter des solutions pour la minimiser l’erreur et augmenter la précision de lecture.

### Etudes sur l’erreur de mesure

Pour avoir une idée de cette erreur de mesure et vérifier si elle est corrigée, je propose de calculer le taux d’erreur de cette expérience. Comme il s’agit d’une série de lectures, la méthode consiste à calculer le taux d’erreur maximal en identifiant le pic de valeur le plus aberrant.

La formule utilisée pour ce calcul est :

Taux d'erreur (%)=(|R_(aberrante) -R_(référence) |)/(R_(référence))×100

Dans notre expérience :

La valeur de référence (résistance fixe branchée) est R_(référence) =475 kΩ .

La valeur du pic le plus aberrant est R_(aberrante) =473 kΩ (valeur à remplacer).

Le taux d’erreur lié à cette expérience est donc de :

Taux d'erreur=(|473-475|)/475×100=0.42%

### Solutions enviables pour la minimisation des erreurs :

#### 1.7.1.1. Filtrage des données et élimination des valeurs aberrantes

D'après l'analyse des expériences menées, nous avons constaté que le système de mesure génère parfois des pics de tension parasites autour de la valeur réelle. Puisqu'une série d'acquisitions est réalisée avant d'en calculer la moyenne, il est préférable d'éliminer ces pics (valeurs aberrantes) avant d'effectuer le moyennage.

##### Comment localiser les valeurs aberrantes ?

Mes recherches montrent qu'un filtre médian est particulièrement efficace pour supprimer ce type de bruit impulsionnel. Cependant, un filtre médian classique ne renvoie qu'une seule valeur (l'élément central), ce qui élimine une grande partie de l'information.

##### Principe de l'algorithme retenu

A. Acquisition :

Une série de N données est collectée dans un tableau (ex. N=700 acquisitions).

B. Tri de la liste :

Les valeurs sont triées par ordre croissant. Grâce à ce tri, les valeurs aberrantes (extrema trop faibles ou trop élevés) se retrouvent reléguées aux extrémités de la liste, tandis que les valeurs les plus cohérentes se regroupent au centre.

C. Extraction et moyennage centré :

Plutôt que de ne conserver que la médiane unique à l'indice (taille)/2 , nous effectuons une moyenne arithmétique sur un échantillon restreint autour de cette valeur centrale.

Pour une série de N= 700 acquisitions, nous proposons de calculer la moyenne sur les 500 valeurs centrales, soit de l'indice (N/2-250) jusqu'à l'indice (N/2+250) .

La valeur résultante offre ainsi une estimation beaucoup plus fiable et plus proche de la résistance réelle recherchée.

##### Analyse des résultats et efficacité du filtre :

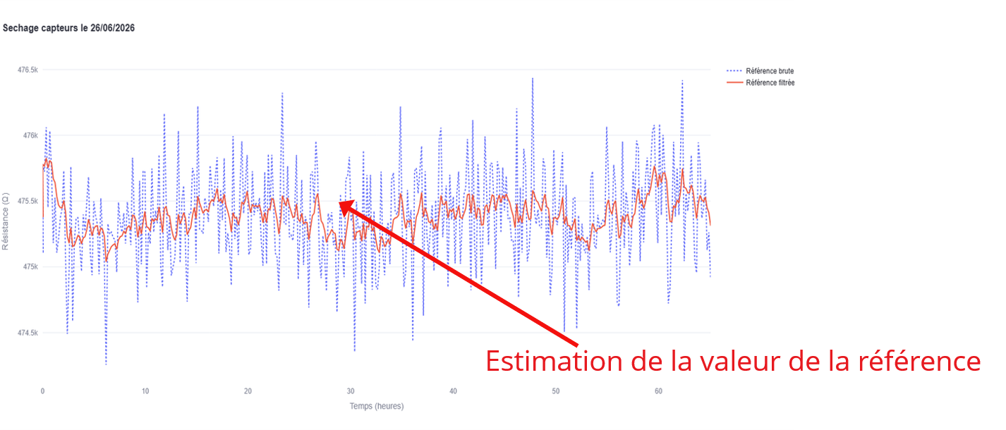
[picture p58: figure]

L'image ci-dessus illustre le résultat de l'application de ce filtre sur les données de l'expérience précédente :

Courbe bleue : Données brutes et bruitées obtenues sans filtrage.

Courbe rouge : Données filtrées par notre méthode basée sur le filtre médian.

On constate nettement sur la courbe rouge une forte réduction des amplitudes d'oscillation. Les nouvelles valeurs obtenues sont beaucoup plus proches de la résistance fixe de 475 kΩ branchée sur le dispositif de mesure.

Cette approche permet de recalculer le taux d'erreur afin de mesurer l'efficacité du filtrage sur ce type de système. Pour rappel, l'erreur relative sur les données brutes (sans filtre) était de 0,42 %.

Taux d'erreur(filtre)=(|475.1-475|)/475×100=0.021%

### Problèmes liés au filtre Median :

Sur une carte ATmega2560, traiter 700 acquisitions avec cette méthode pose 3 problèmes principaux qu'il faut résoudre :

#### 1.7.1.2. La mémoire RAM limitée :

L'ATmega2560 ne dispose que de 8 Ko de RAM. Stocker 700 valeurs sous un format lourd comme float ou long risque de saturer la mémoire et de faire planter la carte. Pour éviter cela, on peut réduire le nombre d'acquisitions, étant donné qu'un filtre est déjà utilisé pour supprimer les bruits de mesure aberrants.

#### 1.7.1.3. Le temps de calcul du tri (Surcharge du processeur) :

Trier une liste de 700 éléments demande beaucoup d'opérations pour un processeur à 16 MHz. Un mauvais algorithme (comme le tri à bulles) fige le système pendant le calcul.

On peut alors envisager d’utiliser une des fonctions de tri optimisées de la bibliothèque standard C (qsort).

#### 1.7.1.4. Le risque de dépassement de capacité (Overflow) :

Additionner 500 valeurs pour faire la moyenne dépasse la capacité d'une variable classique 16 bits. Utiliser une variable accumulateur de 32 bits (uint32_t) pour stocker la somme sans perte de données est une des solutions utiliser actuellement.

## 1.8. Séchage de Capteur :

Pour avoir une idée de la façon dont le capteur se déshydrate, j'ai plongé deux capteurs dans de l'eau pendant au moins 30 minutes, jusqu'à leur saturation en eau. Après cela, j'ai exposé ces capteurs à l'air libre. Je précise que ces expériences ont été réalisées en période de canicule ; la chaleur de l'air ambiant peut donc avoir un impact sur la rapidité de séchage des capteurs, auquel cas l'expérience sera reproduite une seconde fois.

Pour cette expérience, j'ai fait une lecture des données des deux capteurs sur une période de 1 heure, soit une fréquence d'échantillonnage de 1/3600 Hz .

Cette expérience a été réalisée sur une durée de 180 heures, mais les données utilisées dans l'image ci-dessous sont limitées à 83 heures. J'ai choisi de limiter les données à 83 heures pour avoir un meilleur rendu visuel de l'image.

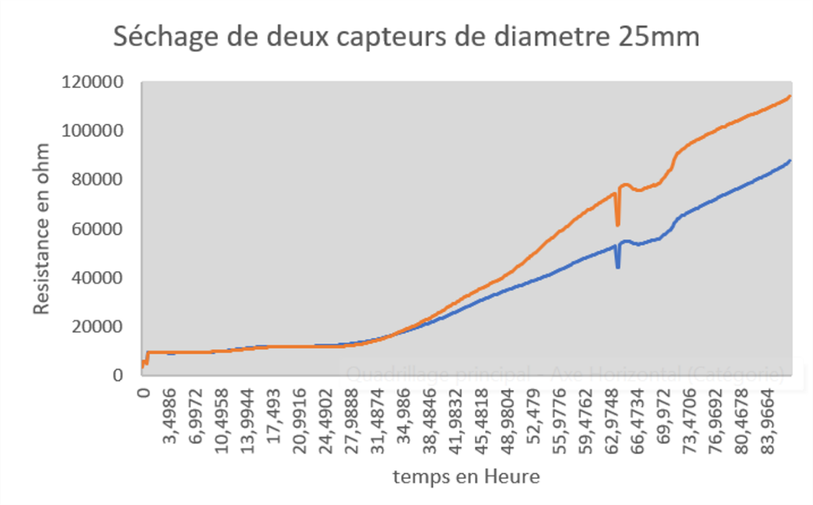
[picture p59: figure]

Sur l'image ci-dessus, on voit nettement comment les deux capteurs sèchent. On constate que la résistance des deux capteurs croît au fil du temps. Cela est dû au fait que, comme ils sont exposés à l'air libre, l'eau contenue dans ces capteurs s'évapore ; le courant électrique qui traverse le capteur devient donc de plus en plus faible. Cela signifie que la résistance augmente car le courant passe de moins en moins.

### Évolution du capteur 1 par rapport au capteur 2

Pour comprendre comment les capteurs se déshydratent et vérifier s'ils se déshydratent de la même manière, je propose de faire une analyse des données en calculant le rapport entre les deux capteurs. Cela nous permettra de savoir comment un capteur évolue par rapport à l'autre.

Sur l'image ci-dessous est représenté le rapport entre les données des capteurs en fonction du temps.

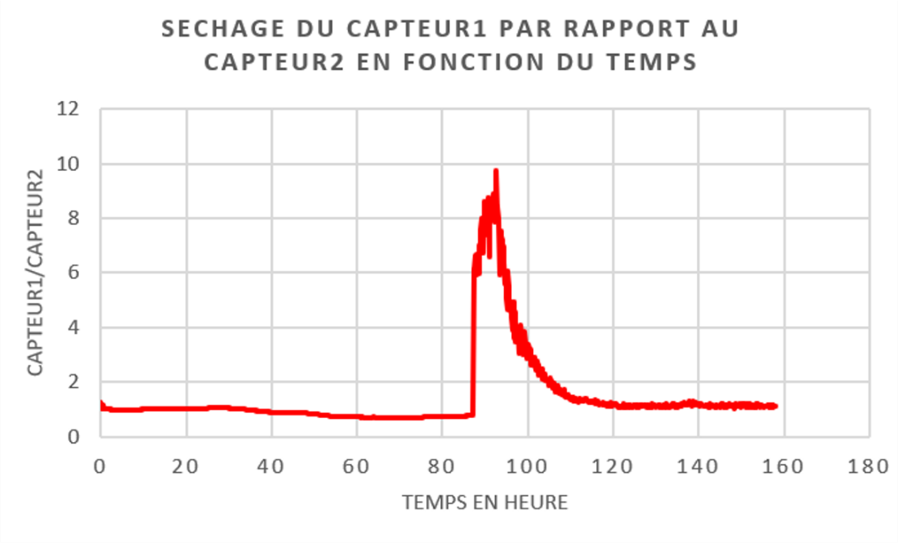
[picture p60: figure]

COMMENTAIRE

## 1.9. Mesures de 4 capteurs à des pF différents :

On cherche à étudier l'évolution de la réponse des capteurs à différents potentiels hydriques ( pF ). Pour ce faire, un banc d'essai a été mis en place. Le système de mesure comprend une résistance fixe de référence de 825 kΩ , quatre capteurs « Waou » (version 4.4) ainsi qu'un capteur du commerce Watermark.

La résistance fixe permet de vérifier la conformité des données lues (et donc de valider le bon fonctionnement de l'électronique), tandis que le capteur Watermark sert de référence pour évaluer les performances des capteurs version 4.4.

### Fonctionnement de la table de succion

[Image : Table à succion]

La table de succion permet de simuler le sol et la rétention d'eau. Il est possible de régler le niveau d'eau dans la table, laquelle contient un substrat assimilable à de la terre. Un irromètre est intégré à l'ensemble pour mesurer le potentiel hydrique ( pF ) du milieu en parallèle des données relevées par les sondes, sur une plage de mesure allant de 0 à 40 kPa (avec 1 kPa=10 mbar ).

La table est équipée d'un tube de niveau, un outil servant à régler le pF du milieu.

Les différents capteurs sont placés dans des cylindres distincts. Toutefois, le capteur n°4 a été installé dans le même cylindre que le capteur Watermark.

Cette expérience permettra également de conclure sur la répétabilité de fabrication des capteurs, c'est-à-dire de vérifier s'il est possible de produire des sondes présentant un comportement identique lorsqu'elles sont placées dans des conditions similaires.

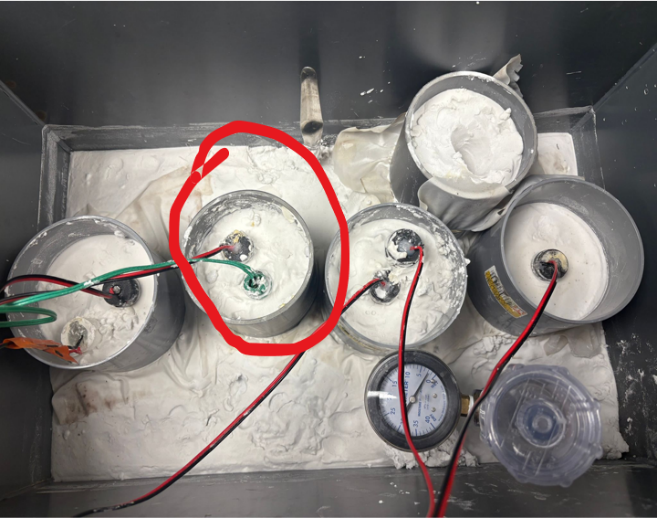
[picture p61: figure]

### Stratégie d'expérimentation : Déshydratation du milieu :

Dans cette expérience, le choix s'est porté sur la simulation d'une déshydratation progressive du milieu. Au début de l'essai, la table est réglée à un pF très bas ( 0,4 ), correspondant à une saturation en eau du substrat. Au fil du temps, le pF du milieu est augmenté étape par étape.

Cette approche offre une fenêtre d'observation nettement plus large pour analyser le changement d'état et la dynamique de réponse des capteurs. En effet, le processus inverse (l'hydratation du milieu et des capteurs) est beaucoup plus rapide que la déshydratation, ce qui rendrait la mesure et la distinction des paliers plus difficiles.

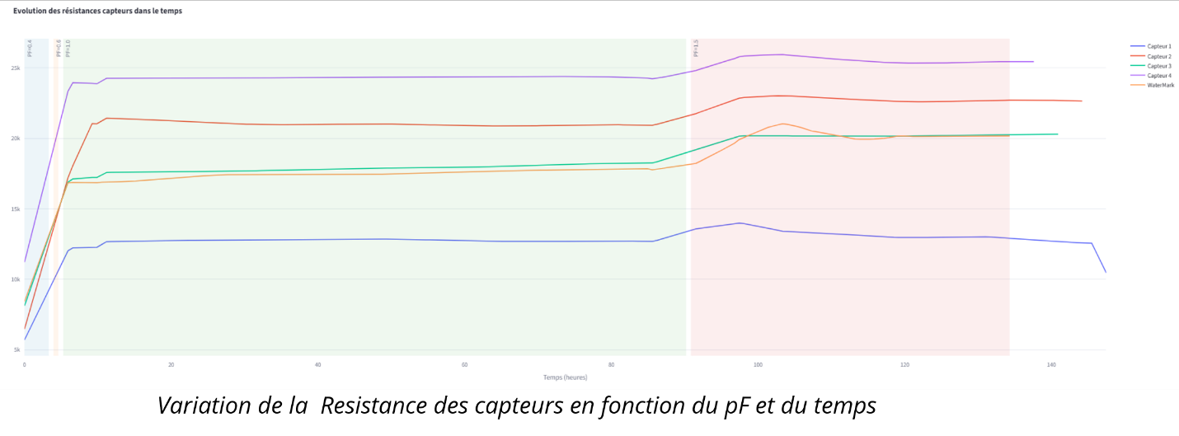
[picture p62: figure]

## 1.10. Bilan énergétique des capteurs version 4.4 :

Pour l etude cocercernant le bilan energetique du de puis propose de faire de faire des mesure et etudes sur les cas pesimiste ( les forte consolution ) car ces elle est imporse la duréé de foctionne système de mesure sur batterie , on considere alors que une lecteure des capteur(8) au totale est fait chaque heure et que nous etudieron la consommation du dispositif sur une duree de une heure ,la carte de mesure(MEGA 2560) fonctionnera de manière constante durant toute la duree de l experience

### Puissance limite Utilisée

### Energie utilisée

## 1.11. Bilan Energétique de la carte Méga 2560

# Conclusion et Bilans

Bilan scientifique et technique du stage :

ce qu’il faut retenir de vos travaux, résultats marquants et difficultés techniques

Bilan personnel :

ce que cela vous a apporté en termes d’expérience, de compétences acquises ou mobilisées… difficultés rencontrées (= en gros, montée en compétences, découverte d’un domaine, complémentarité avec la formation, aspect relationnel…).

Ouverture/Perspectives :

quelles sont les perspectives pour l’entreprise ou pour vous...

# Bibliographie

Références des articles scientifiques aux formats standard (cf. Google Scholar ou autre source) intégrant un lien DOI cliquable (préalablement vérifié) et donnant accès à la ressource.

# Webographie

Pour les sites web consultés UNIQUEMENT = Les cours de 4A sur la recherche bibliographique et l’état de l’art réalisé pour le TER doivent vous aider sur ces aspects.

## 1.12. Annexes

Ils ne doivent pas contenir de code, mais des figures et/ou tableaux et/ou explications complémentaires qui doivent bien sûr être cités dans le corps du document (= cf. Annexe figure Y page X). Il faut, en tout cas, expliquer ce que ces éléments apportent à la partie principale de votre rapport. Si ce n’est pas référencé, c’est que ça n’apporte rien. Les missions auxiliaires non développées dans le corps du rapport peuvent y être mentionnées brièvement. Cette annexe devra comporter une section relative à l’usage de l’IAG dans la rédaction du rapport.
