djibril99/stageIRD/Documents/version2026/Rapport2026.docx

# Plan

## I. Contexte de l‘étude

## II. Principe d’un capteur résistif

## III. Fabrication des capteurs

## IV. Validation de la carte de mesure et du code
