djibril99/stageIRD/Documents/ancienneVersion (old)/Calcul des coéfficients d'expansion FINAL.docx

Calcul des coefficients d’expansion et du facteur de bridage

V0

V0

ΔVlibre

t0

Tf dans système ouvert

Tf dans système fermé

V0

ΔVbridé

L0

L0

L0

ΔLlibre

ΔLbridé

Coefficient d’expansion dans tube ouvert : α_(libre) =(∆V_(libre))/(V_0)=(∆L_(libre))/(L_0)

Ce coefficient se mesure dans le tube, avec mesure de la hauteur du mélange à t0 et tf.

Coefficient d’expansion bridé dans tube fermé : α_(bridé) =(∆V_(bridé))/(V_0)

Cette façon d’exprimer l’expansion permet de connaitre la porosité totale du matériau :

Porosité φ(%) = α/(1+α) * 100

On peut définir un facteur de bridage de l’expansion : β=1-(α_(bridé))/(α_(libre))

Ce facteur sera compris entre 0 et 1. (ou 0 et 100)

Si pas de bridage β=0

Si bridage total ∆V_(bridé) =0 donc α_(bridé) =0 donc β=1

Exemple avec ce que tu as présenté ce matin :

α_(libre) =1,5 (mesure avec le tube transparent)

α_(bridé) (avec système Besançon)=1,5 Donc β=0

PHOTO1

α_(bridé) (avec système serre-joint)=1,1 Donc β=0.27 (27%)

PHOTO2

Pour remplir un tube avec un coefficient α_(bridé) , il faut mettre Vtube/ (1+α_(bridé) ) de mélange dans le fond du tube.

Cette manière d’exprimer les coefficients d’expansion est la même que pour la dilatation

thermique.

V0

V0

ΔVlibre

Avant expansion

Fin d’expansion dans système ouvert

Fin d’expansion dans système fermé

V0

ΔVbridé

L0

L0

L0

ΔLlibre

ΔLbridé
