djibril99/stageIRD/Documents/ancienneVersion (old)/FIT UNE LISTE DE CE QUE TU AS FAIT.docx

FIT UNE LISTE DE CE QUE TU AS FAIT (PPT) ET DE CE QUE TU DOIS FAIRE

imprimer les bouchon de tubes d'expansion en PLA

imprimer les Bouchons des capteurs version Manel ? diametre 25

Formation sur table à succion

Acheter pour capteur

- tiges filetées quel diamètre ?)
- écrous (quel diamètre ?)
- Ciment
- Chaux verif
- Gypse verif
- Bobine PLA

Acheter pour mesure

Jeudi

Les résultats
