djibril99/stageIRD/Documents/ancienneVersion (old)/les versions capteurs.pptx

Évolution du capteur :

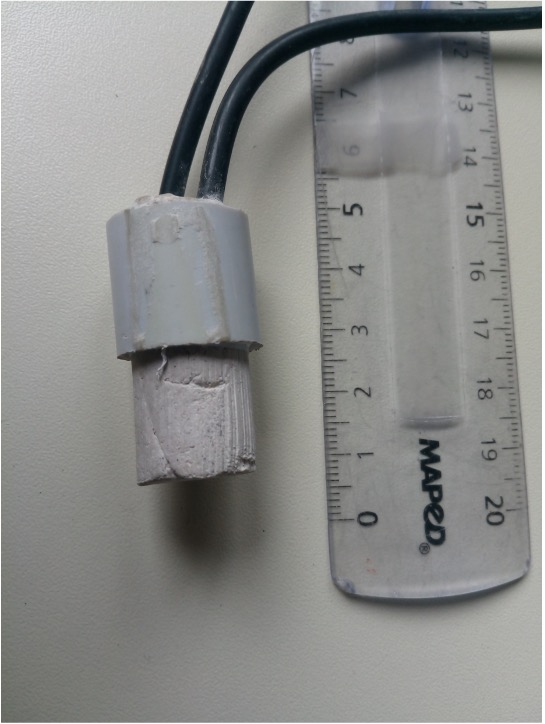
[picture p105: figure]

V0.0
- Argile
- Cuivre

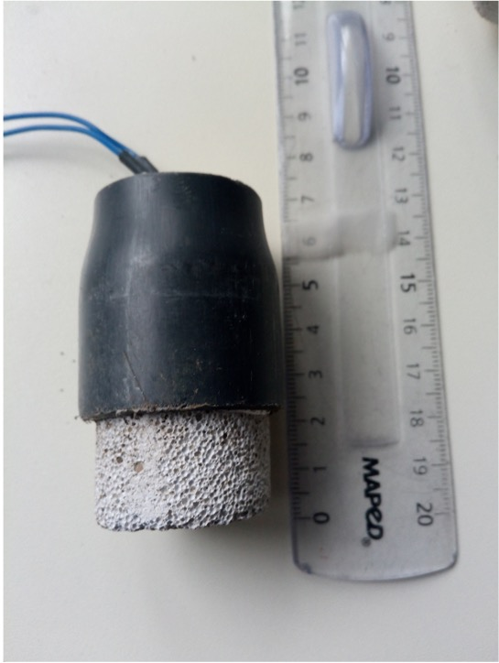
[picture p106: figure]

V1.0
- Béton cellulaire
- Cuivre

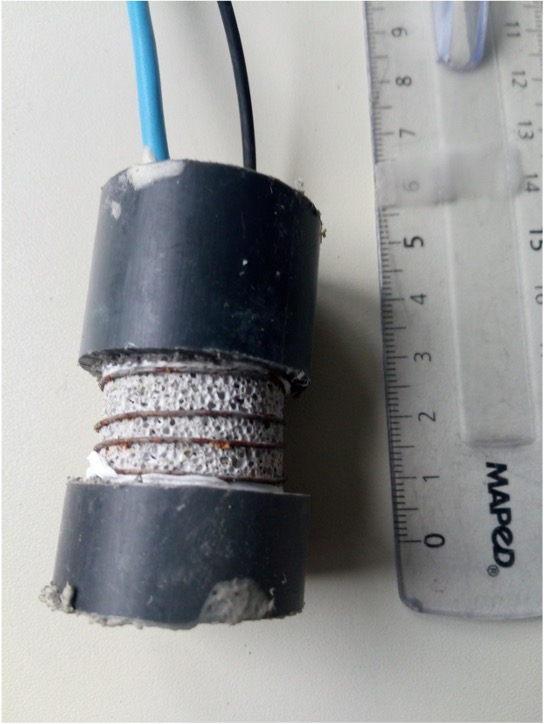
[picture p107: figure]

V1.2
- Electrode externe en acier

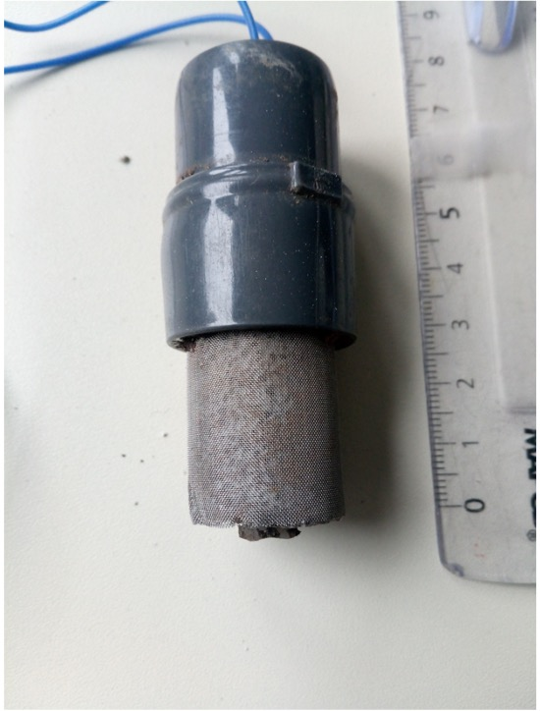
[picture p108: figure]

V2.0
- Tige en Acier Inox
- Grille Acier 304L

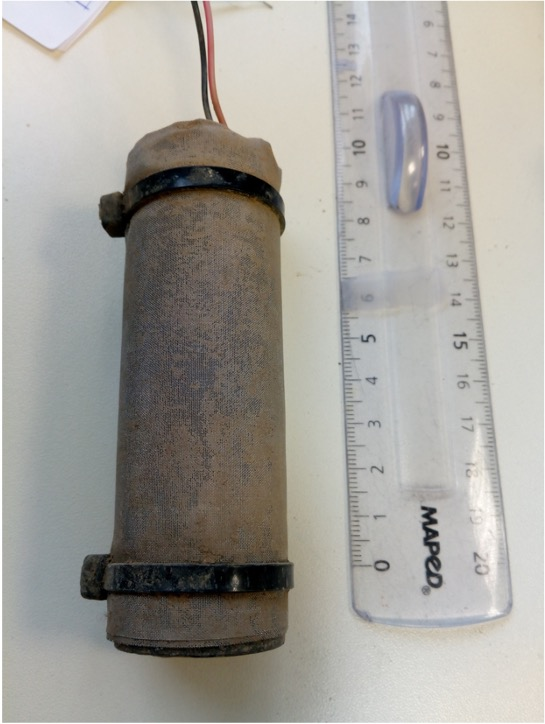
[picture p109: figure]

V3.0
- Béton Cellulaire Broyé
- Tige Acier 304L

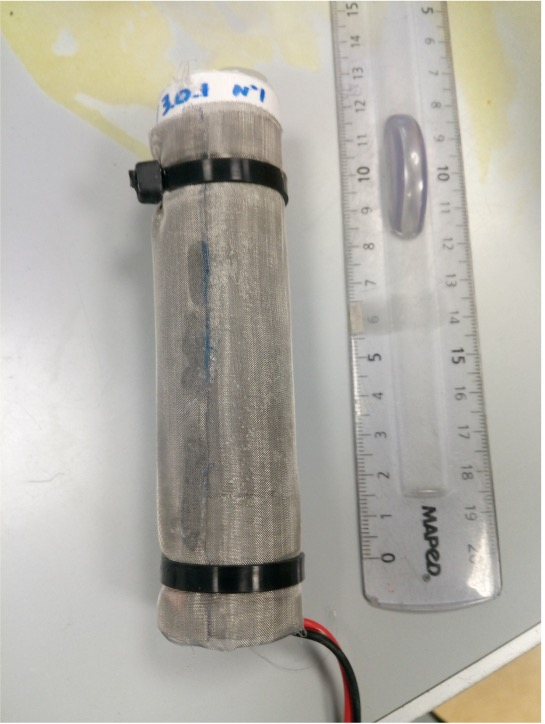
[picture p110: figure]

V3.0.1
- Corps en PLA
- Béton cellulaire Broyé

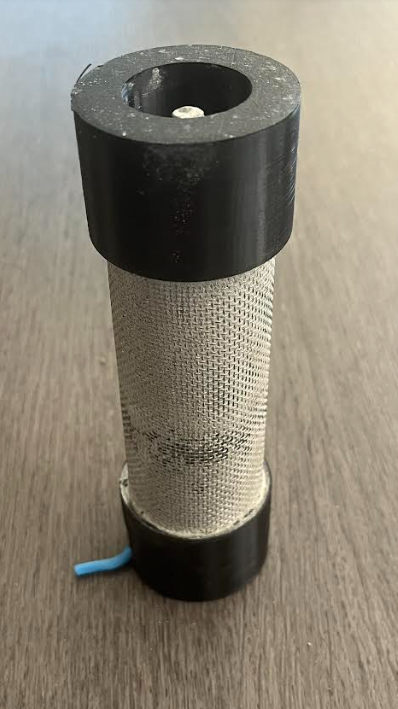
[picture p111: figure]

V4

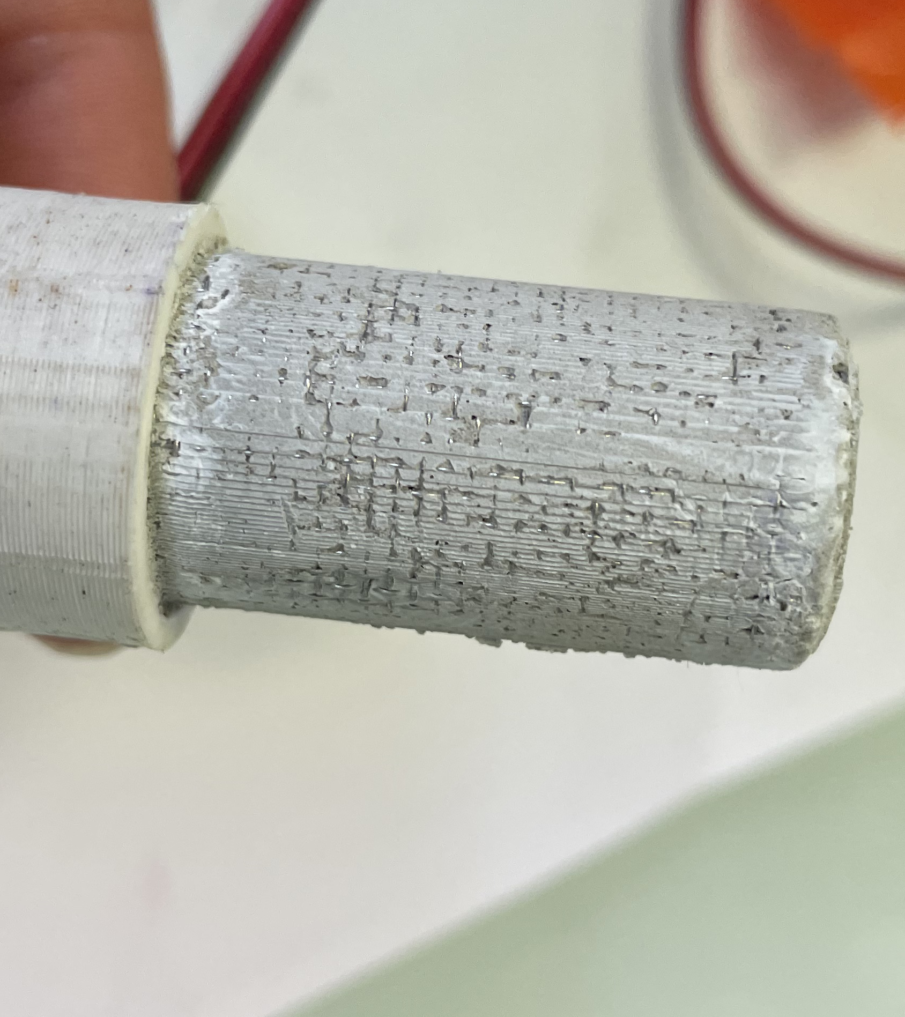
[picture p112: figure]

V5.0
Demi capteur pour application labo
