djibril99/stageIRD/Documents/version2026/imageTypeDeSol.png

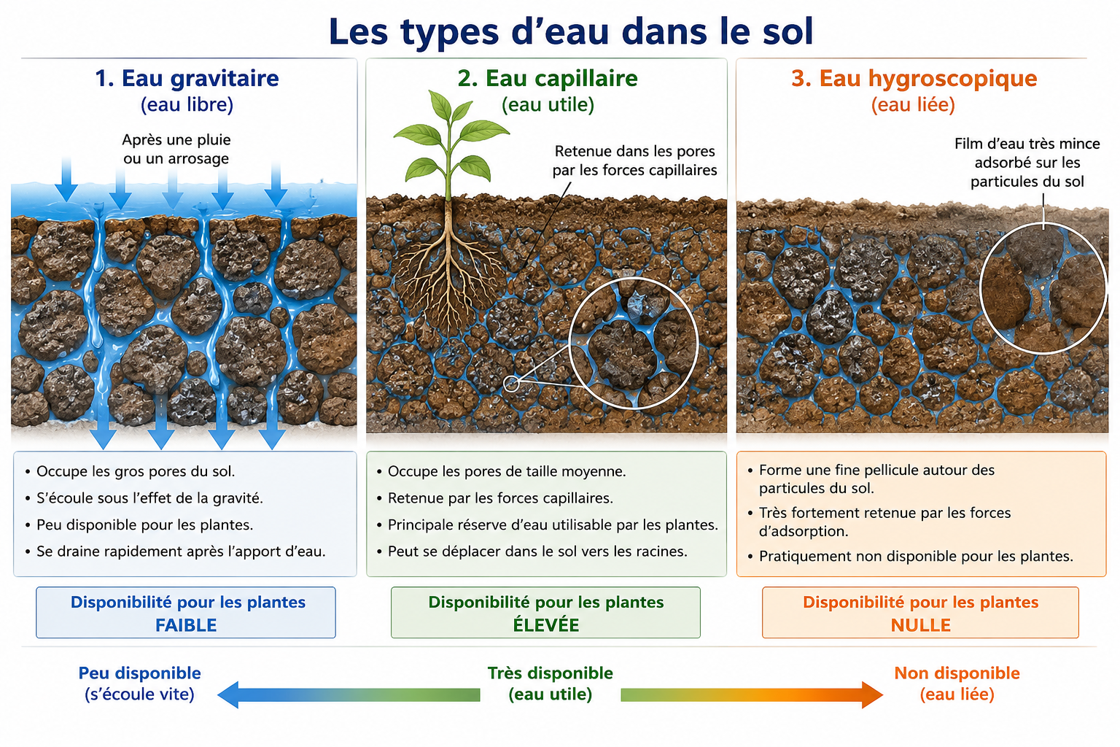
Documents/version2026/imageTypeDeSol.png
