djibril99/stageIRD/donneeCapteur/CapteurManel/graphique.png

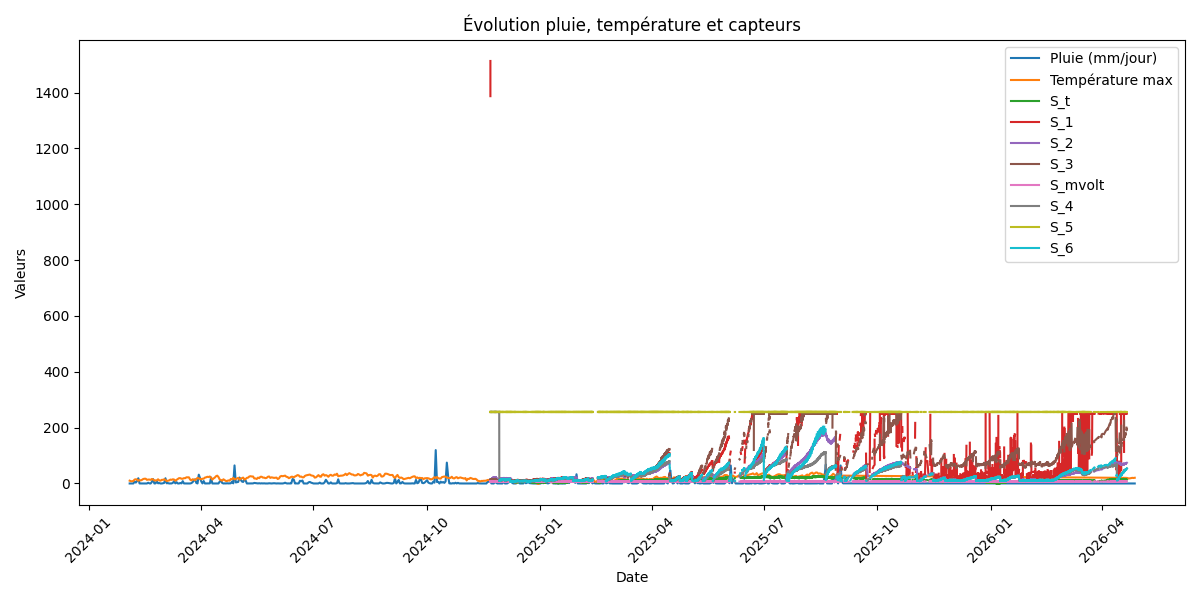
donneeCapteur/CapteurManel/graphique.png
