djibril99/stageIRD/donneeCapteur/v4.4/sechage/allDecalageValeurSechage.png

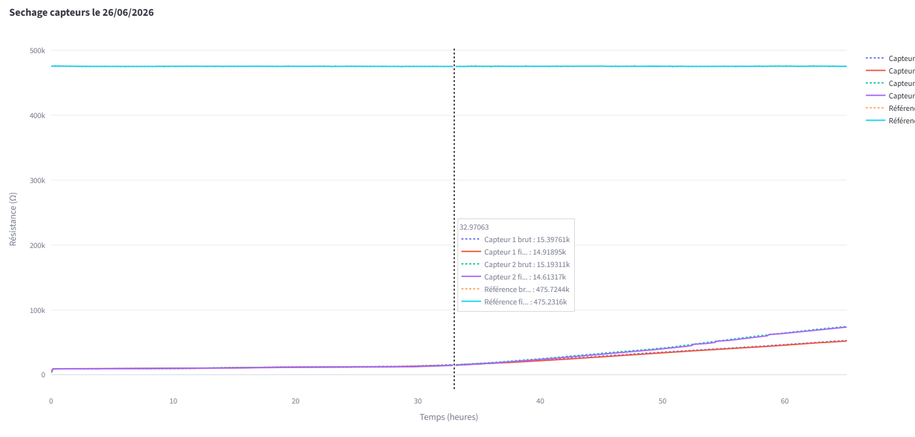
donneeCapteur/v4.4/sechage/allDecalageValeurSechage.png
