djibril99/stageIRD/donneeCapteur/v4.4/sechage/sechageBRUTetFiltreAvecReference.png

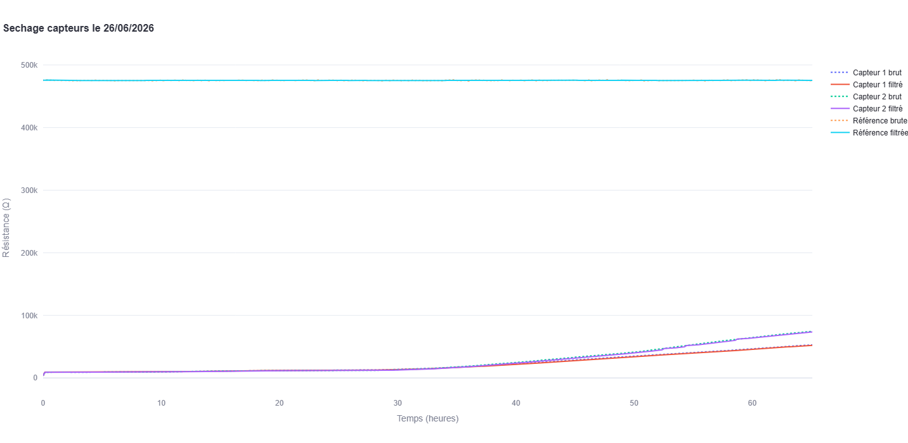
donneeCapteur/v4.4/sechage/sechageBRUTetFiltreAvecReference.png
