djibril99/stageIRD/donneeCapteur/V5-3/collecte12_06_2026/ph0_4.png

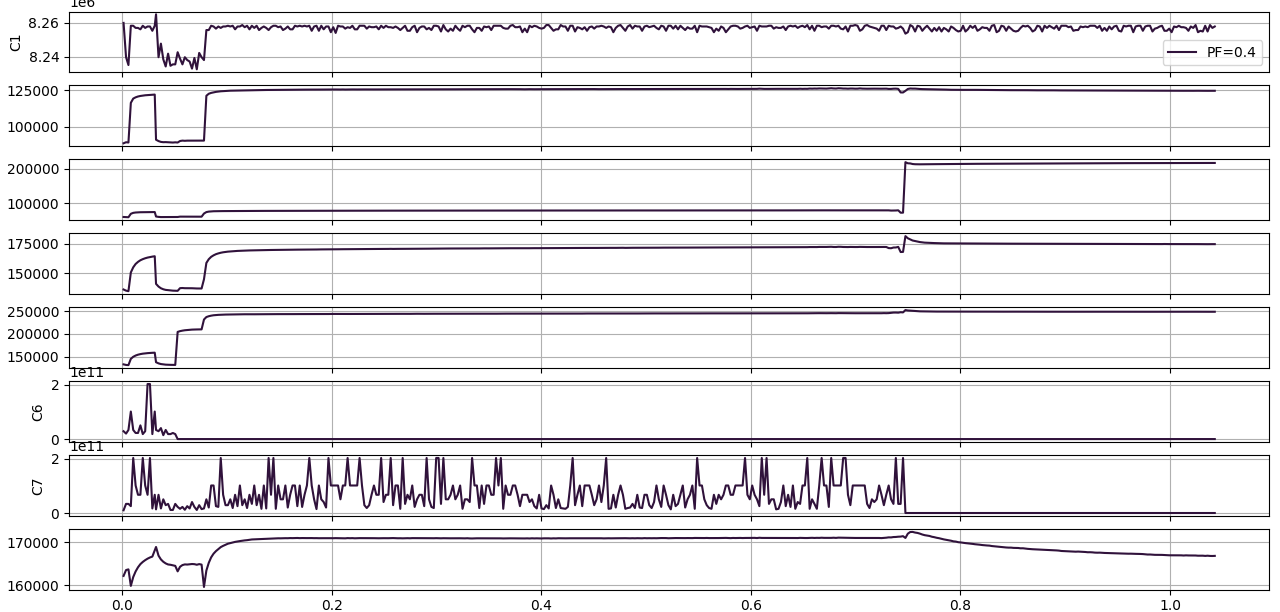
donneeCapteur/V5-3/collecte12_06_2026/ph0_4.png
