djibril99/stageIRD/donneeCapteur/V5-3/DATA/imagegraph/arret mesure.png

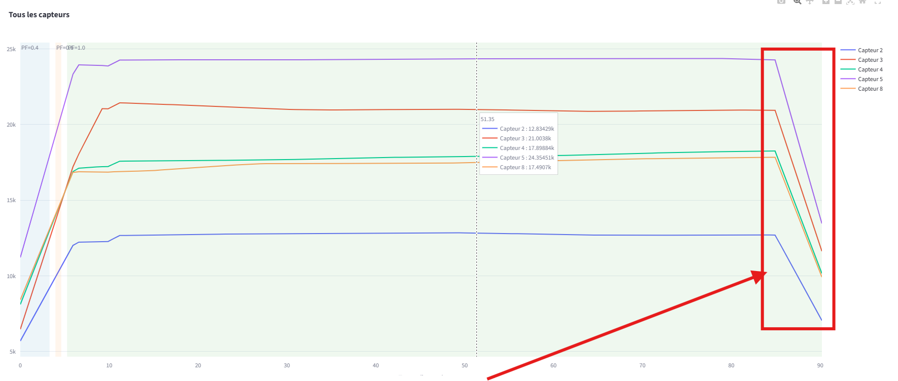
donneeCapteur/V5-3/DATA/imagegraph/arret mesure.png
