djibril99/stageIRD/images/capteur1.jpg

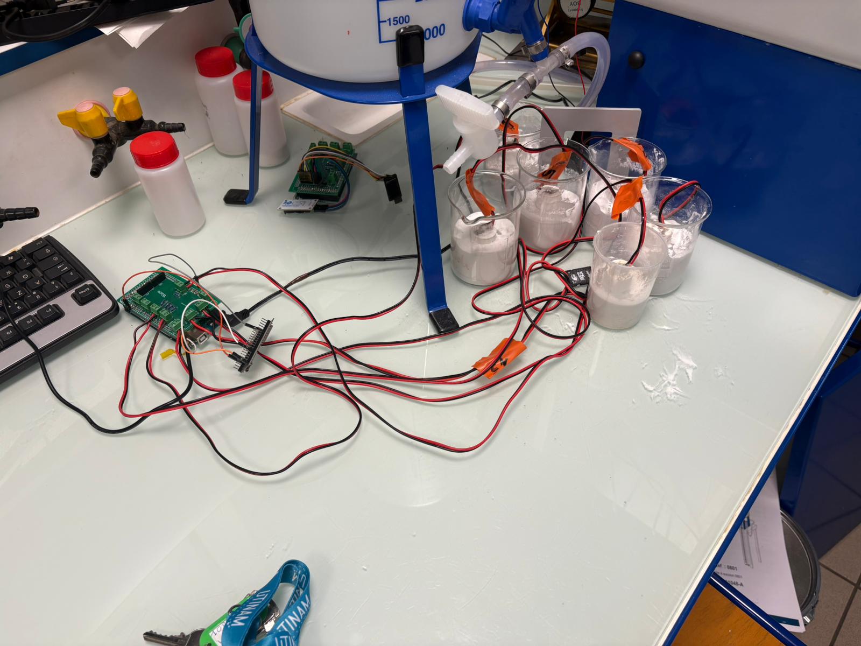
images/capteur1.jpg
