djibril99/stageIRD/images/capteur.jpg

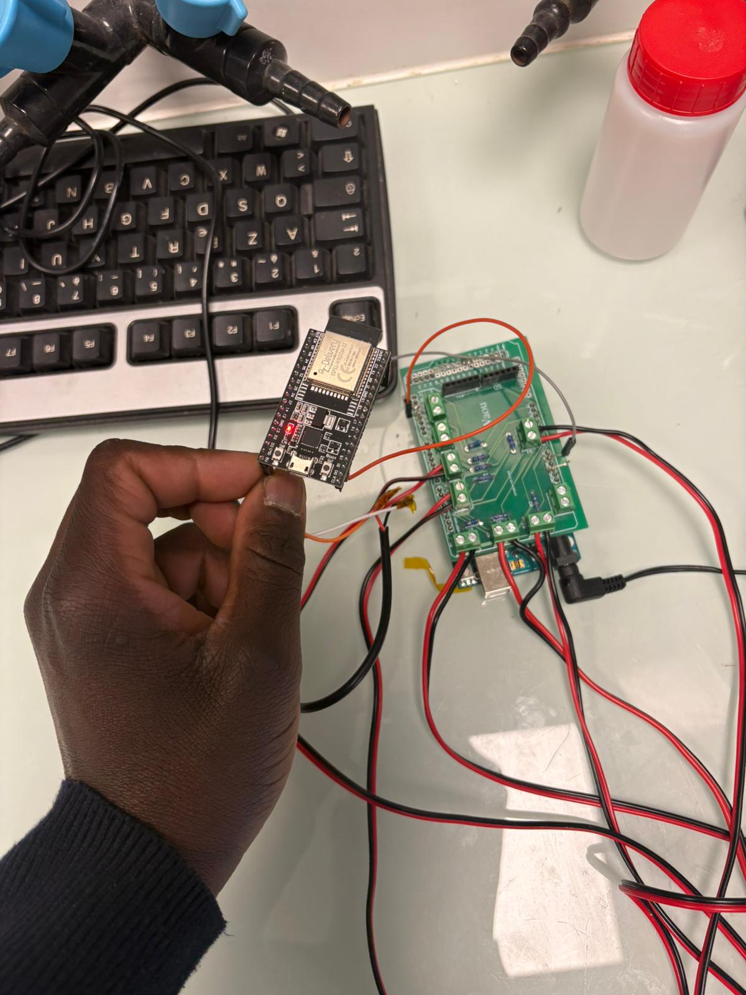
images/capteur.jpg
