djibril99/stageIRD/images/carteManel.jpg

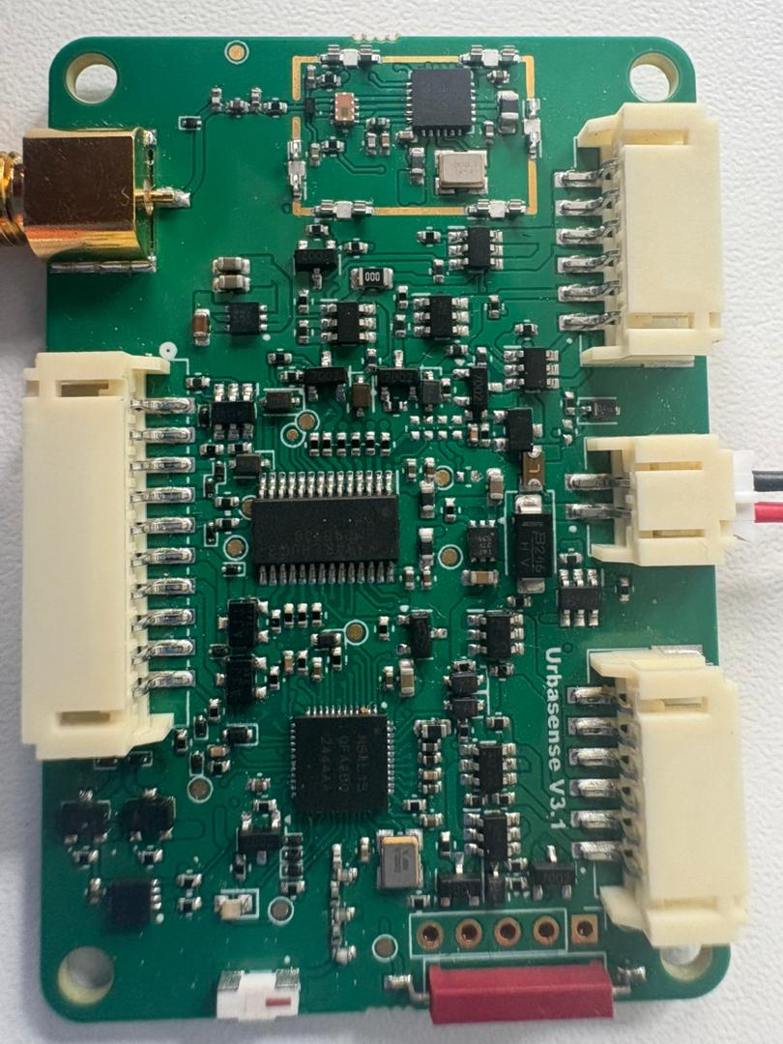
images/carteManel.jpg
