djibril99/stageIRD/images/Image1.png

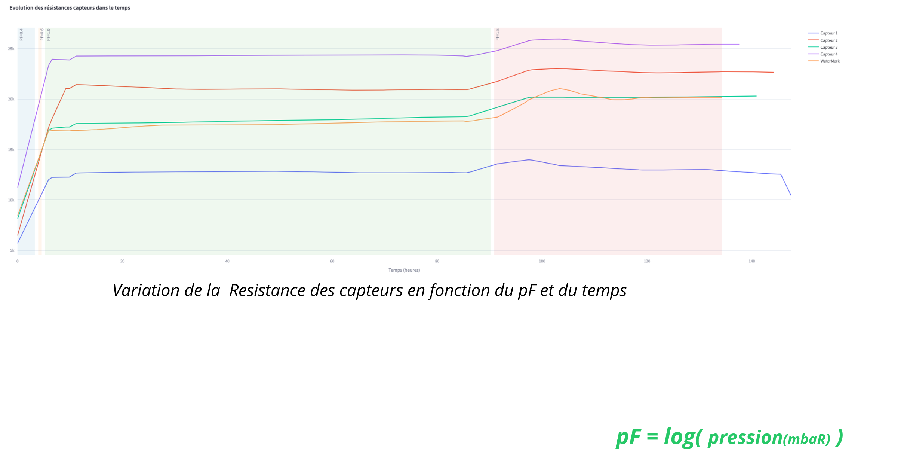
images/Image1.png
