djibril99/stageIRD/images/ImportantRappportPoline.png

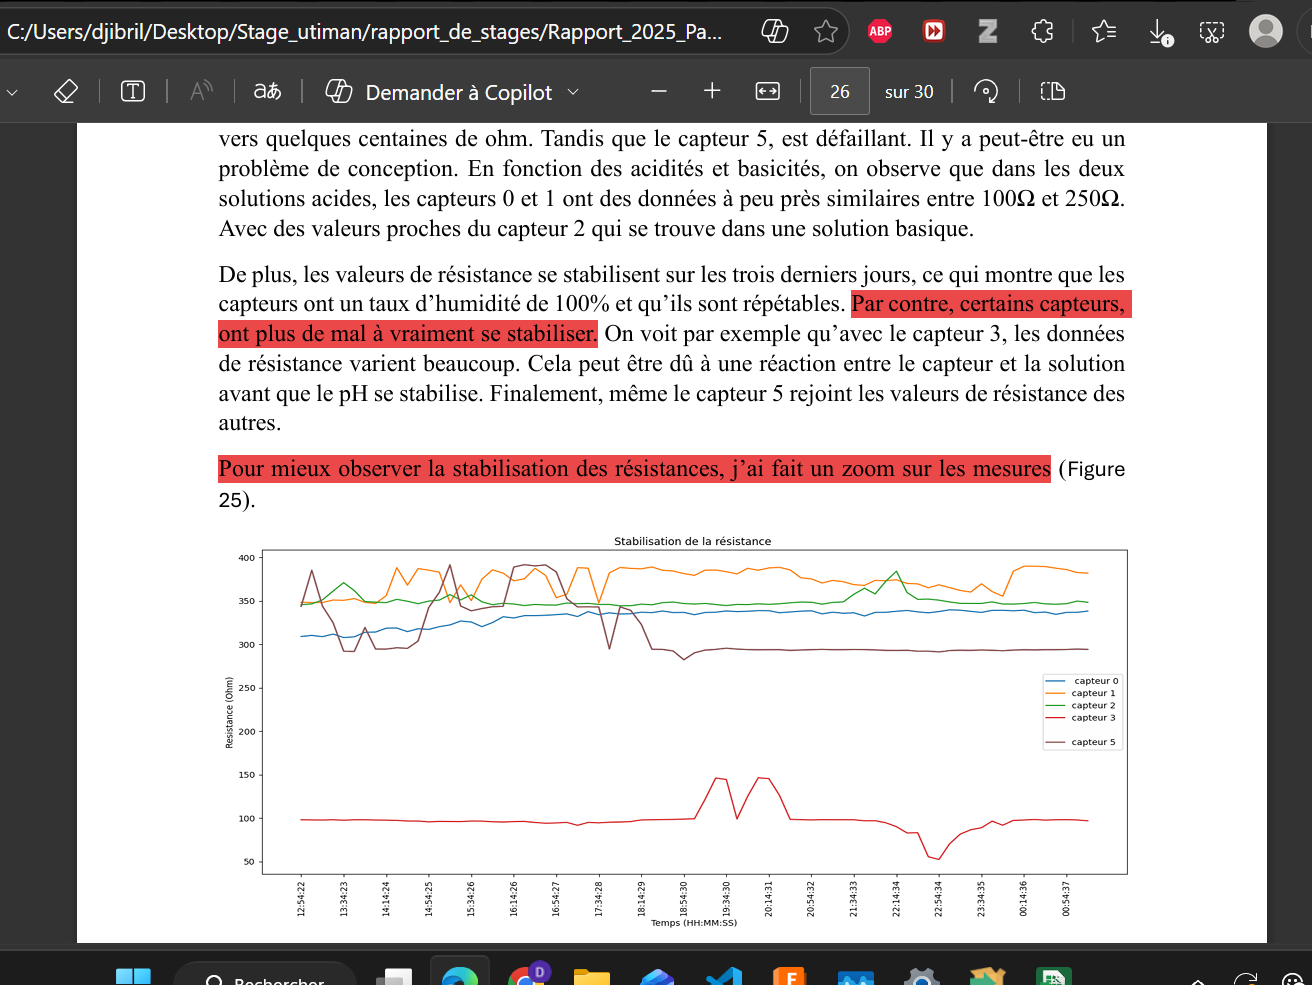
images/ImportantRappportPoline.png
