djibril99/stageIRD/images/PUISSANCEConsommée.png

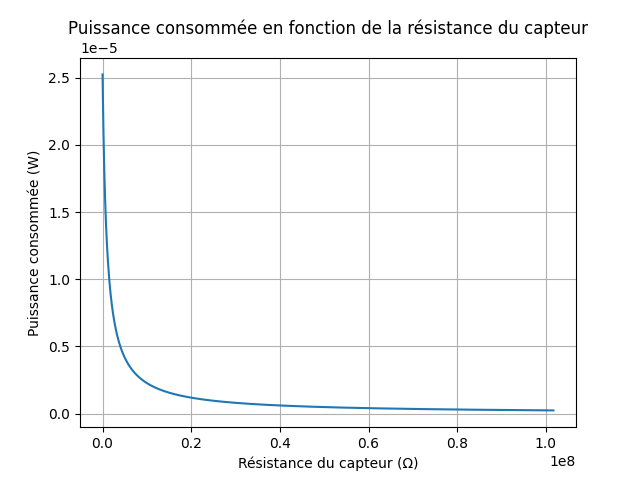
images/PUISSANCEConsommée.png
