djibril99/stageIRD/images/resistanceFixeSuperviseur.png

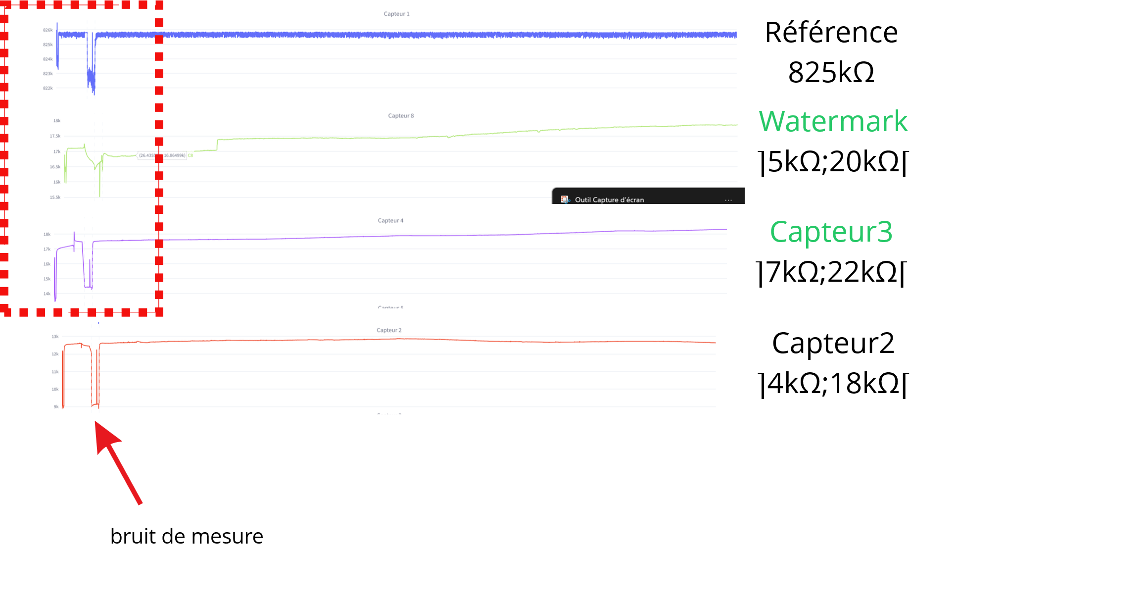
images/resistanceFixeSuperviseur.png
