djibril99/stageIRD/images/sechageCapteur1ParRapportAuCapteur2.png

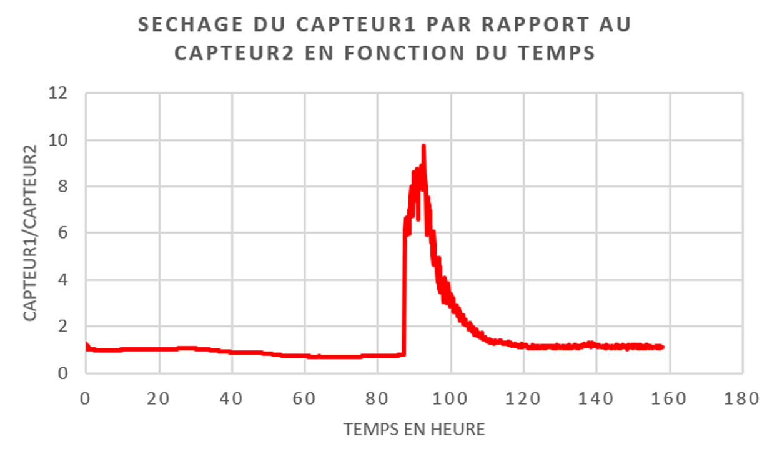
images/sechageCapteur1ParRapportAuCapteur2.png
