djibril99/stageIRD/images/variationCapteurs.png

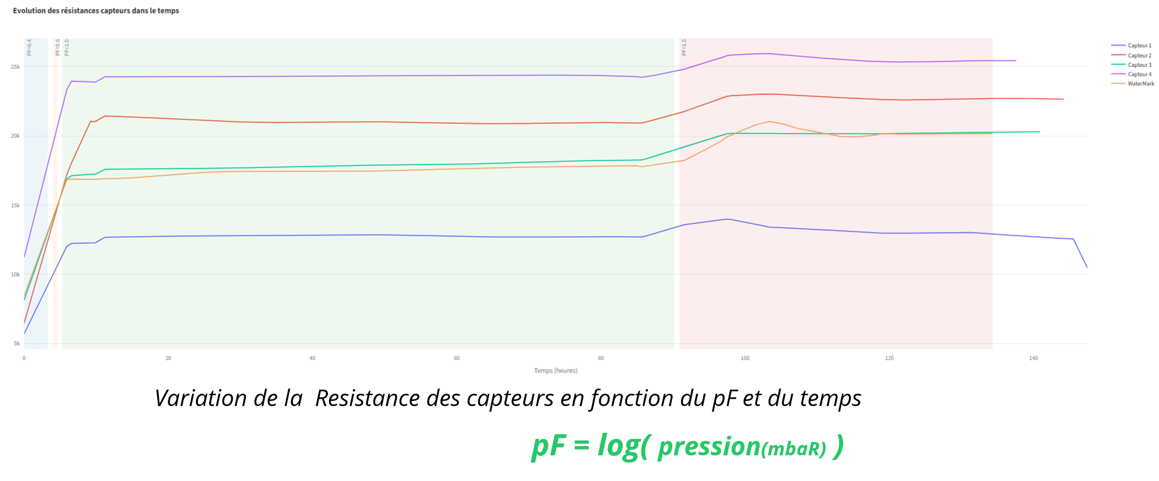
images/variationCapteurs.png
