djibril99/stageIRD/Documents/ancienneVersion (old)/Achat matériel Waou V5-0.xlsx

Sheet: Feuil1
 |  |  |  | Matériel Prototypage Waou
 | matériaux et equipemens | Prix | Fournisseurs
Fabrication du béton cellulaire | Ciment gris ( 3KG) | 28.35 € | https://www.mon-droguiste.com/ciment-refractaire-calorite.html
 | Ciment gris ( 1.5KG)
 | Sable (5kg) | 13.20 € | https://www.mon-droguiste.com/silice-hn38.html
 | ALuminum (500g) | 25.60 € | https://www.mon-droguiste.com/aluminium-poudre.html
 | Methylcellulose (250g) | 21.24 € | https://www.mon-droguiste.com/methylcellulose.html
 | Gyps (1kg) | 3.65 € | https://www.mon-droguiste.com/sulfate-calcium-alimentaire.html
 | Chaux CaO | 6.75 € | https://www.mon-droguiste.com/chaux-vive.html
 | Chaux CaOH (500g) | 5.00 € | https://www.mon-droguiste.com/hydroxyde-calcium.html
Petit Matériels | Grille Métallique x10 | 15.99 € | https://www.amazon.fr/TIMESETL-Treillis-m%C3%A9tallique-Inoxydable-Filtration/dp/B07ZT2JM43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
 | Tige fileté A2 x 2 | 4.00 € | https://www.leroymerlin.fr/produits/quincaillerie/cheville-vis-clou-et-boulon/tige-filetee/tige-filetee-inox-brut-l-1000-x-diam-8-mm-alfer-65291590.html
 | Ecrou A4 frein | 6.00 € | https://www.leroymerlin.fr/produits/quincaillerie/cheville-vis-clou-et-boulon/ecrou/ecrou-inox/ecrous-freins-hexagonaux-inox-a4-83317100.html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
 | Attache x 25 | 4.00 € | https://www.leroymerlin.fr/produits/quincaillerie/corniere-tube-tole-et-profile/accessoires-de-mecanique/collier-et-patte-de-serrage/lot-de-25-colliers-diam-4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
 | filament PLA (bouchon) | 23.17 € | https://fr.farnell.com/multicomp/mc002547/filament-imprimante-3d-pla-1-75mm/dp/2845494?st=pla
 | Acide phosphorique | 25.90 € | https://www.mon-droguiste.com/acide-phosphorique.html
 | Balance | 320.00 € | https://fr.farnell.com/kern/pcb-2500-2/balance-de-table-2-5kg/dp/2886386?st=balance%200.01
 | fils anode, cahode | 6.00 € | https://www.leroymerlin.fr/produits/electricite-domotique/rallonge-multiprise-enrouleur-et-cable-electrique/fil-et-cable-electrique-gaine-prefilee-et-cable-in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
 | Fils électrique 0.5mm² |  | https://www.amazon.fr/gp/product/B08F7LHG9Q/ref=ox_sc_act_title_2?smid=A21XMLNKVYTGM7&psc=1
 | Cosse diam 8 |  | https://www.amazon.fr/gp/product/B00GWP7C94/ref=ox_sc_act_title_1?smid=A1X6FK5RDHNB96&psc=1
 | Bécher de mesure | 12.40 € | https://www.mon-droguiste.com/becher-mesure.html
 | Manchon PVC diam 32 |  | https://www.leroymerlin.fr/produits/chauffage-plomberie/circuit-alimentation-en-eau/tube-et-raccord-alimentation/raccord-alimentation/generique-manchon-pvc-ff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
 | Manchon PVC diam 40 |  | https://www.leroymerlin.fr/produits/chauffage-plomberie/evacuation-des-eaux-usees/tube-et-raccord-evacuation-eau/raccord-evacuation/manchon-en-pvc-a-coller-fe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
 | Manchon PVC diam 100 |  | https://www.leroymerlin.fr/produits/chauffage-plomberie/evacuation-des-eaux-usees/tube-et-raccord-evacuation-eau/raccord-evacuation/manchon-en-pvc-a-coller-fe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
 | Baton colle à chaud |  | https://www.leroymerlin.fr/produits/outillage/outillage-a-main/pistolet-a-cartouche-pistolet-a-colle/colle-pour-pistolet-a-colle/sac-de-colle-1kg-universelle-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
 | Boite de dérivation |  | https://www.leroymerlin.fr/produits/electricite-domotique/tableau-electrique-et-disjoncteur/accessoires-du-tableau-electrique-bornier-peigne/boite-de-derivati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
 | poche a douille | 10.99 € | https://www.amazon.fr/Pazalor-Plastique-P%C3%A2tissi%C3%A8re-P%C3%A2tisserie-D%C3%A9coration/dp/B08FB2GZ5W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
 | alimentation 5V
 | Pistolet à colle |  | https://www.leroymerlin.fr/produits/outillage/outillage-a-main/pistolet-a-cartouche-pistolet-a-colle/pistolet-a-colle/pistolet-a-colle-filaire-rapid-point-7-m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
Grand Matériels | Table à succion 0-0,1 bar | 4392.92 € | Devis sdec par email
 | colonne a tamis | - | https://www.grosseron.com/retsch-as-200-retsch-nouveau-modele_48-244-1-566-1-1493.html
 | broyeur | -
Total |  | 4925.16 €

Sheet: Achat nov 2023
 |  |  |  |  | Matériel Prototypage Waou
 | matériaux et equipemens | Prix U | Qté | Fournisseurs
Fabrication du béton cellulaire | Ciment gris (25KG) | 5.10 € |  | https://www.leroymerlin.fr/produits/materiaux/beton-ciment-mortier-et-poudre/beton/beton-drainant/ciment-gris-cimalit-ce-cem-ii-32-5-25-kg-80152842.html
 | Chaux CaO | 6.75 € |  | https://www.mon-droguiste.com/chaux-vive.html
 | Chaux CaOH (500g) | 5.00 € |  | https://www.mon-droguiste.com/hydroxyde-calcium.html
Petit Matériels | Grille Métallique (maille 0.59mm) A vérifier | 14.99 € | 3 | https://www.amazon.fr/TIMESETL-Treillis-m%C3%A9tallique-Inoxydable-Filtration/dp/B07ZT2RNZ2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
 | Tige fileté A2 x 2 | 2.26 € | 2 | https://www.leroymerlin.fr/produits/quincaillerie/cheville-vis-clou-et-boulon/tige-filetee/tige-filetee-m3-inox-a2-din-975-88246777.html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
 | Ecrou M3 inox A2 frein x30 | 7.30 € | 1 | https://www.leroymerlin.fr/produits/quincaillerie/cheville-vis-clou-et-boulon/ecrou/ecrou-frein/ecrou-hexagonal-indesserrable-hi-m3-x-30pcs-autobloquant-frein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
 | filament PLA (bouchon) | 23.17 € |  | https://fr.farnell.com/multicomp/mc002547/filament-imprimante-3d-pla-1-75mm/dp/2845494?st=pla
 | fils anode, cahode | 6.00 € |  | https://www.leroymerlin.fr/produits/electricite-domotique/rallonge-multiprise-enrouleur-et-cable-electrique/fil-et-cable-electrique-gaine-prefilee-et-cable-in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
 | Cosse diam 3 |  | 15 | https://www.amazon.fr/gp/product/B00GWP7C94/ref=ox_sc_act_title_1?smid=A1X6FK5RDHNB96&psc=1
 | Lot de 10 tubes tulipes IRL diam.20 mm gris |  |  | https://www.leroymerlin.fr/produits/chauffage-plomberie/circuit-alimentation-en-eau/tube-et-raccord-alimentation/raccord-alimentation/generique-manchon-pvc-ff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
Total |  | 70.57 €
