djibril99/stageIRD/Documents/RE_ Suite Point_ Lancement stage djibril/.stl

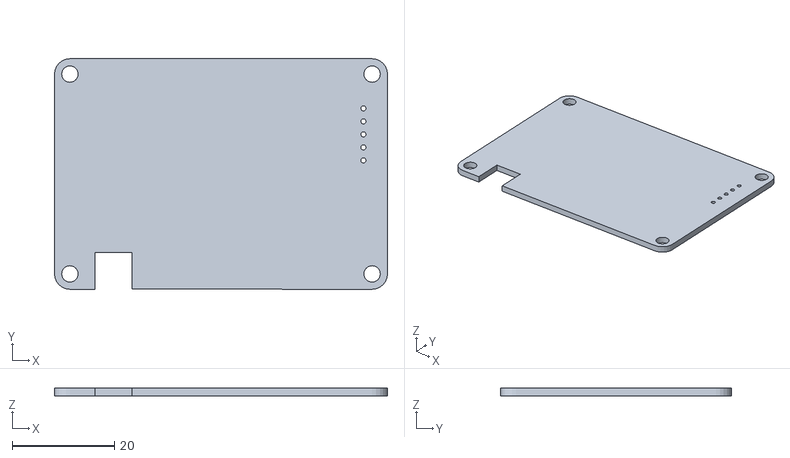
[picture p189: CAD file, 2026-06-10]
Documents/RE_ Suite Point_ Lancement stage djibril/.stl
65.0 x 45.0 x 1.51
