djibril99/stageIRD/Model3D/V4_4LONG/bas.stl

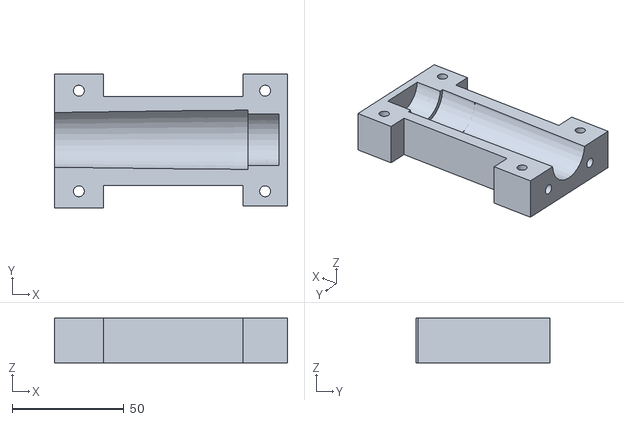
[picture p190: CAD file, 2026-07-15]
Model3D/V4_4LONG/bas.stl
104.2 x 60.0 x 20.0
