djibril99/stageIRD/Model3D/V4_4SMALL/bouchounBas.stl

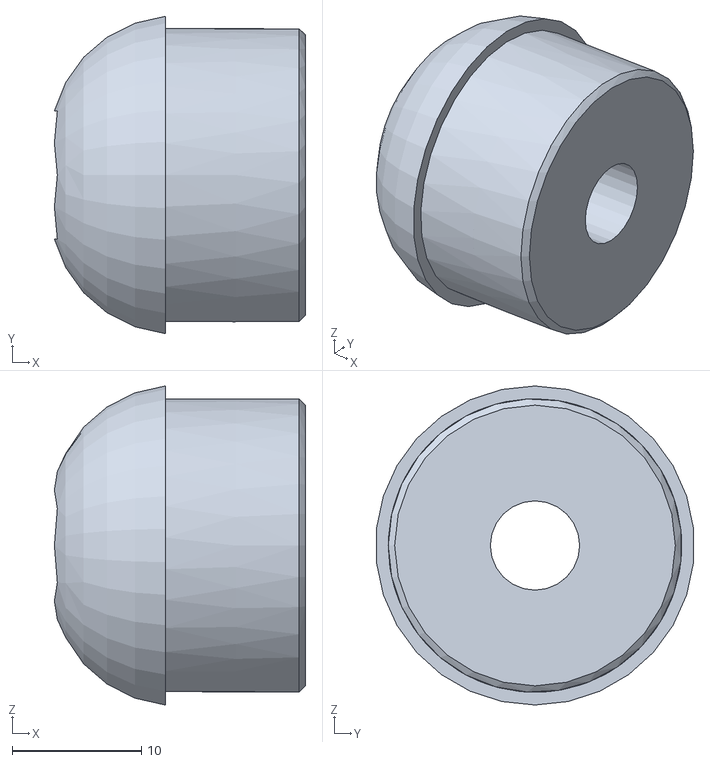
[picture p191: CAD file, 2026-07-15]
Model3D/V4_4SMALL/bouchounBas.stl
19.4 x 24.5 x 24.6
