djibril99/stageIRD/Model3D/versionManel/Bouchon inferieur ecrou pousser a 5 mm_(4).stl

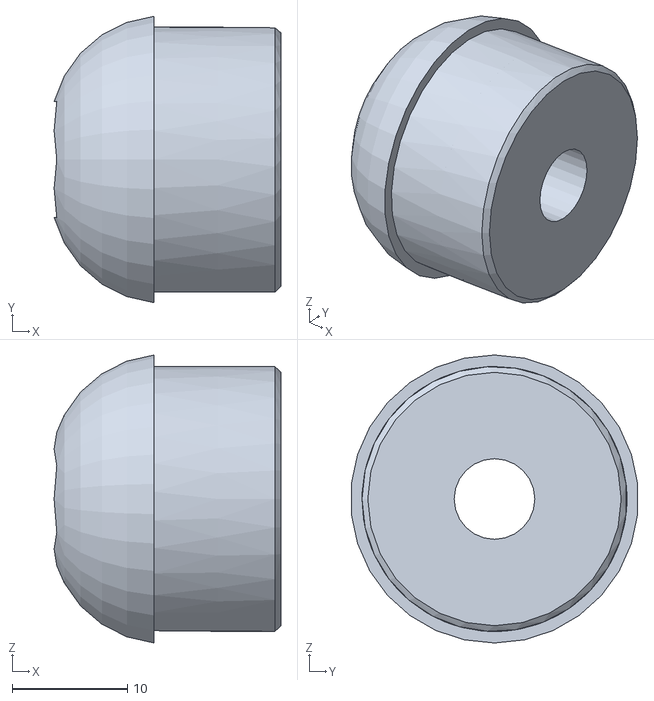
[picture p192: CAD file, 2026-04-28]
Model3D/versionManel/Bouchon inferieur ecrou pousser a 5 mm_(4).stl
19.7 x 24.9 x 25.0
