djibril99/stageIRD/Model3D/à supprimer/V5_3/bas.stl

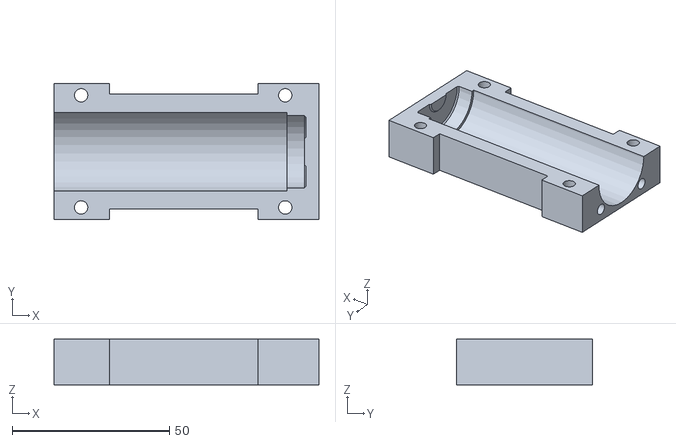
[picture p193: CAD file, 2026-06-10]
Model3D/à supprimer/V5_3/bas.stl
84.1 x 43.3 x 14.5
