djibril99/stageIRD/Model3D/V4_4LONG/fermeture.stl

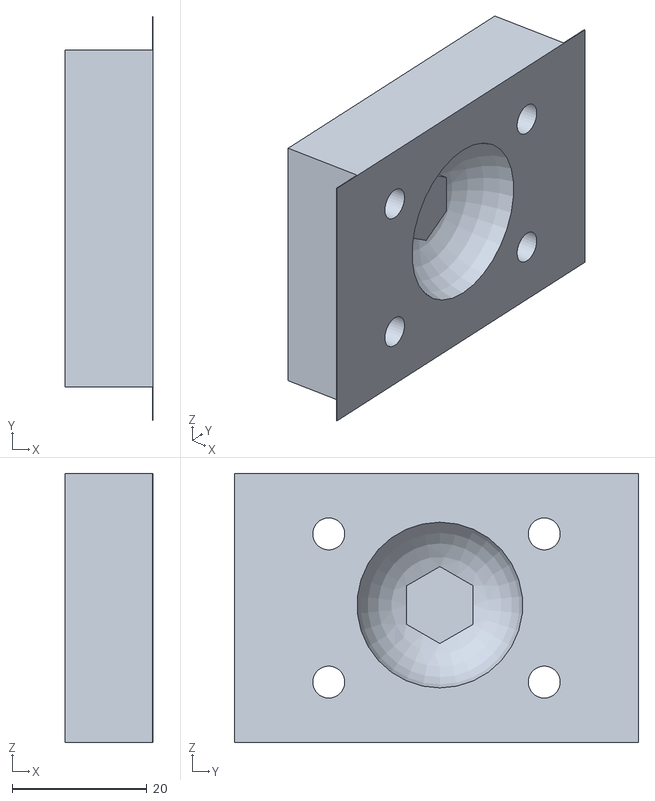
[picture p194: CAD file, 2026-07-15]
Model3D/V4_4LONG/fermeture.stl
13.1 x 60.0 x 40.0
