djibril99/stageIRD/Model3D/V4_4SMALL/fermeture.stl

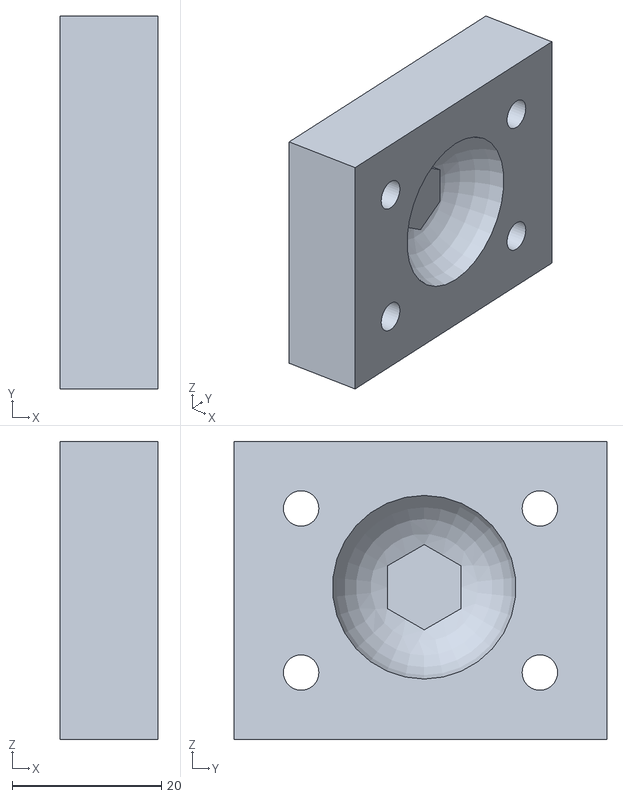
[picture p195: CAD file, 2026-07-15]
Model3D/V4_4SMALL/fermeture.stl
13.1 x 50.0 x 40.0
