djibril99/stageIRD/Model3D/versionManel/Bouchon superieur avec alesage de coche(2).stl

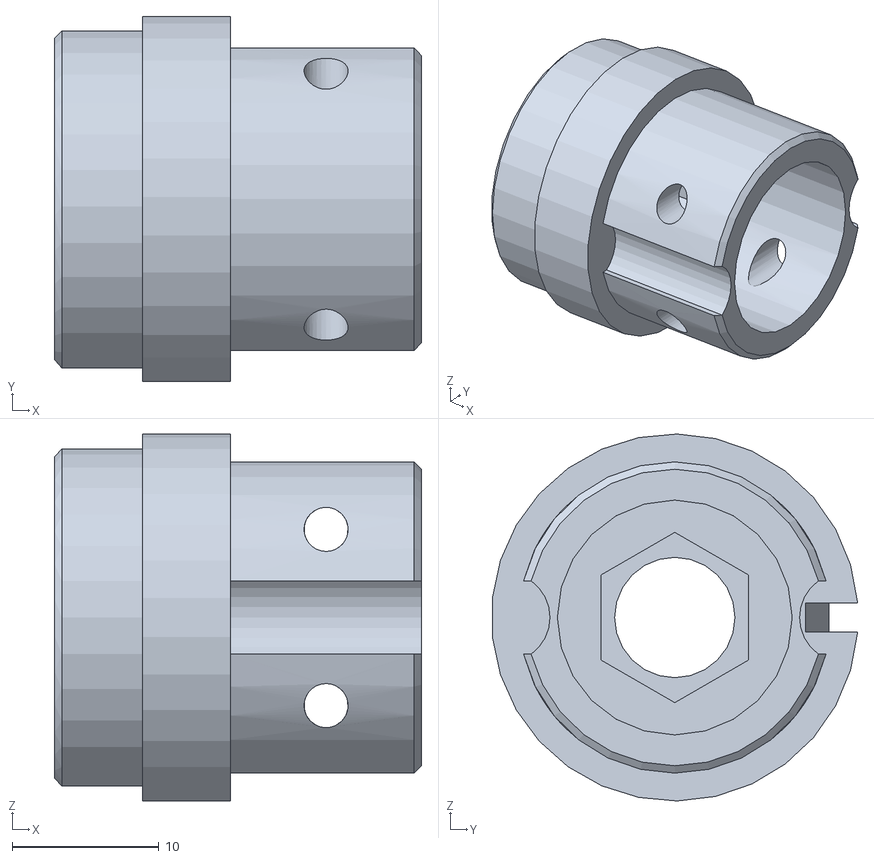
[picture p196: CAD file, 2026-04-28]
Model3D/versionManel/Bouchon superieur avec alesage de coche(2).stl
25.0 x 24.9 x 25.0
