djibril99/stageIRD/Model3D/à supprimer/V5_3/fermeture.stl

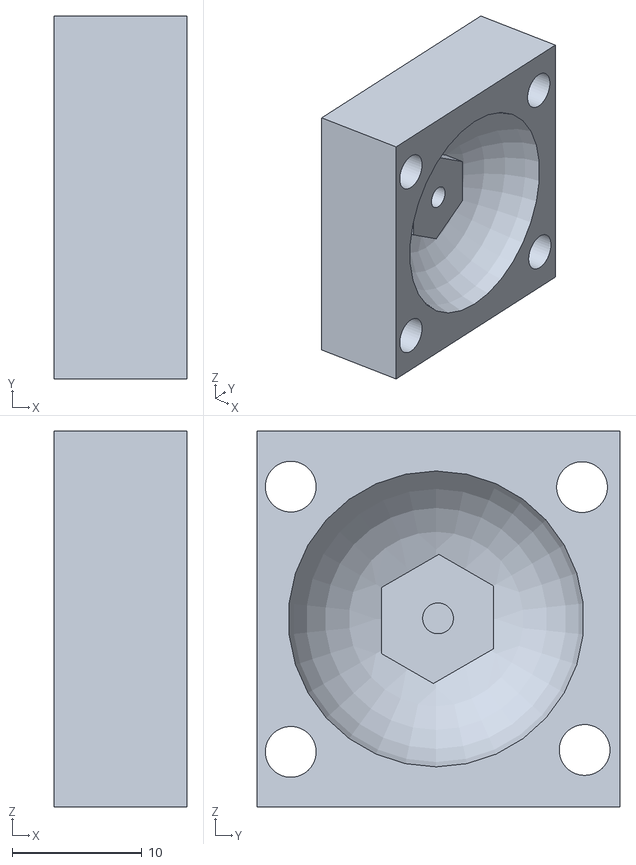
[picture p197: CAD file, 2026-06-10]
Model3D/à supprimer/V5_3/fermeture.stl
10.2 x 27.9 x 28.9
