djibril99/stageIRD/Model3D/V4_4SMALL/haut.stl

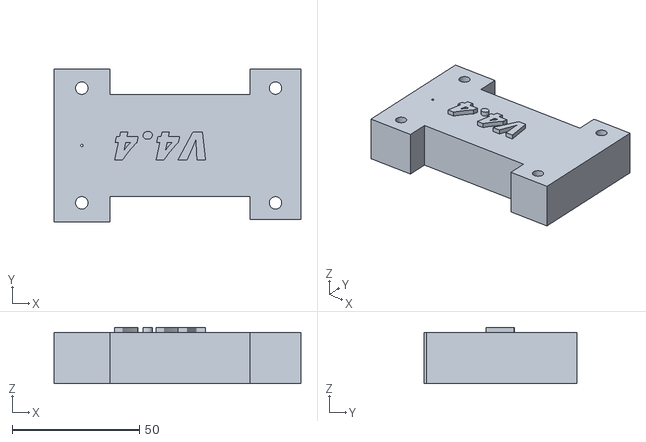
[picture p198: CAD file, 2026-07-15]
Model3D/V4_4SMALL/haut.stl
96.9 x 60.0 x 22.0
