djibril99/stageIRD/Model3D/V4_4LONG/bouchonHaut22mm.stl

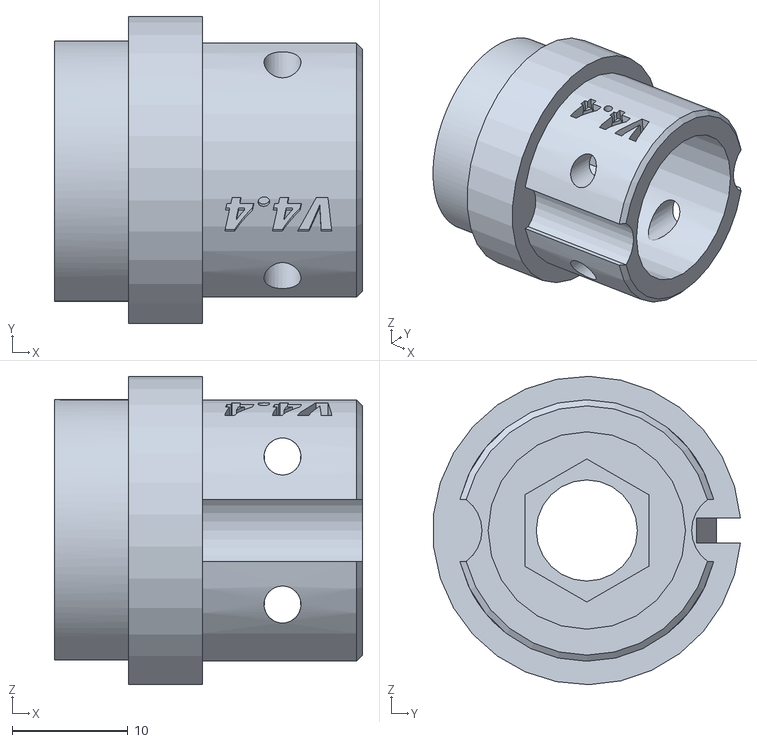
[picture p199: CAD file, 2026-07-15]
Model3D/V4_4LONG/bouchonHaut22mm.stl
26.7 x 26.5 x 26.6
