djibril99/stageIRD/Model3D/V4_4LONG/haut.stl

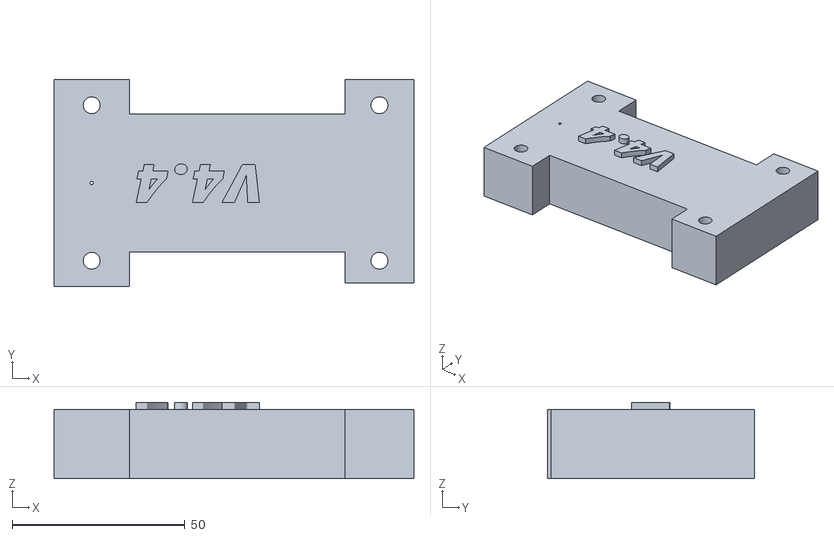
[picture p200: CAD file, 2026-07-15]
Model3D/V4_4LONG/haut.stl
104.2 x 60.0 x 22.0
