djibril99/stageIRD/Model3D/V4_4SMALL/bas.stl

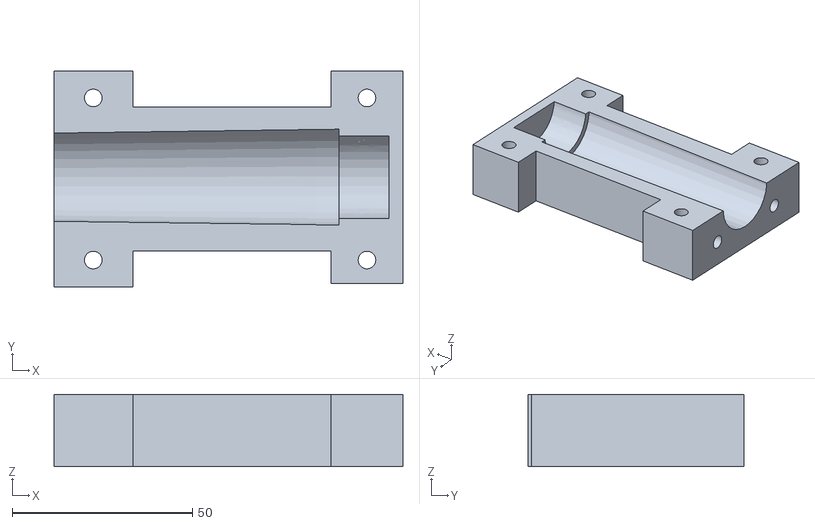
[picture p201: CAD file, 2026-07-15]
Model3D/V4_4SMALL/bas.stl
96.9 x 60.0 x 20.0
