djibril99/stageIRD/Model3D/à supprimer/v5_1/Bouchonbas.stl

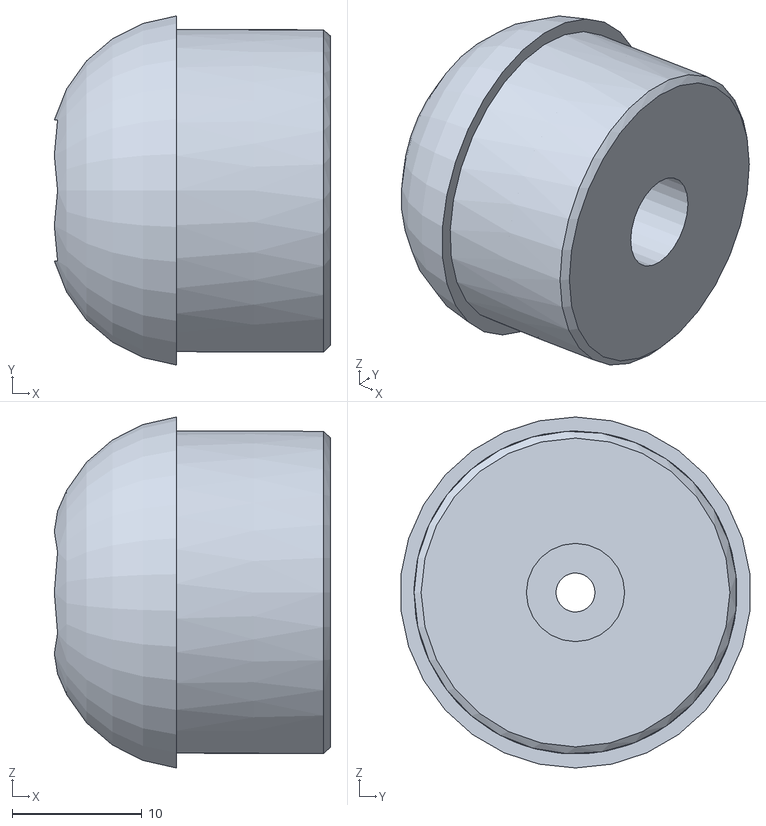
[picture p202: CAD file, 2026-06-10, an earlier design]
Model3D/à supprimer/v5_1/Bouchonbas.stl
21.3 x 26.9 x 27.1
