djibril99/stageIRD/(list of files, cad)

Other CAD files:
Model3D/à supprimer/V5_3/haut.stl
Model3D/V4_4SMALL/Corps de maillage1.stl
Model3D/V4_4SMALL/bouchonHaut.stl
Model3D/V4_4SMALL/V53L.f3z
Model3D/à supprimer/V5_2/BouchonHaut.stl
Model3D/à supprimer/V5_2/Bouchonbas.stl
Model3D/à supprimer/V5_2/bas.stl
Model3D/à supprimer/V5_2/fermeture.stl
Model3D/à supprimer/V5_2/haut.stl
Model3D/à supprimer/v5_1/BouchonHaut.stl
Model3D/à supprimer/v5_1/CURA1.3mf
Model3D/à supprimer/v5_1/bas.stl
Model3D/à supprimer/v5_1/fermeture.stl
Model3D/à supprimer/v5_1/haut.stl
Model3D/à supprimer/version1/moudules3D_V5.1/bas.stl
Model3D/à supprimer/version1/moudules3D_V5.1/bouchon1.stl
Model3D/à supprimer/version1/moudules3D_V5.1/bouchon2.stl
Model3D/à supprimer/version1/moudules3D_V5.1/femeture.stl
Model3D/à supprimer/version1/moudules3D_V5.1/haut.stl
Model3D/à supprimer/version2/Corps8.stl
Model3D/à supprimer/version2/HAUT.stl
Model3D/à supprimer/version2/bas.stl
Model3D/à supprimer/version2/fermeture.stl
