djibril99/stageIRD/Documents/version2026/FabricationCapteurs.docx

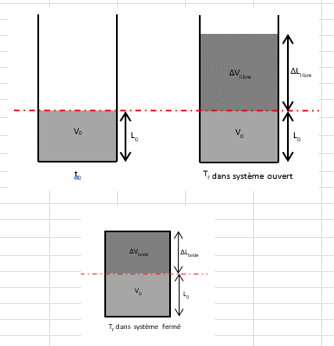
[picture p203: figure]

Calcul du coefficient d’expansion

Bridage du capteur à 12%

Calul de la quantité de matière pour 3 capteurs

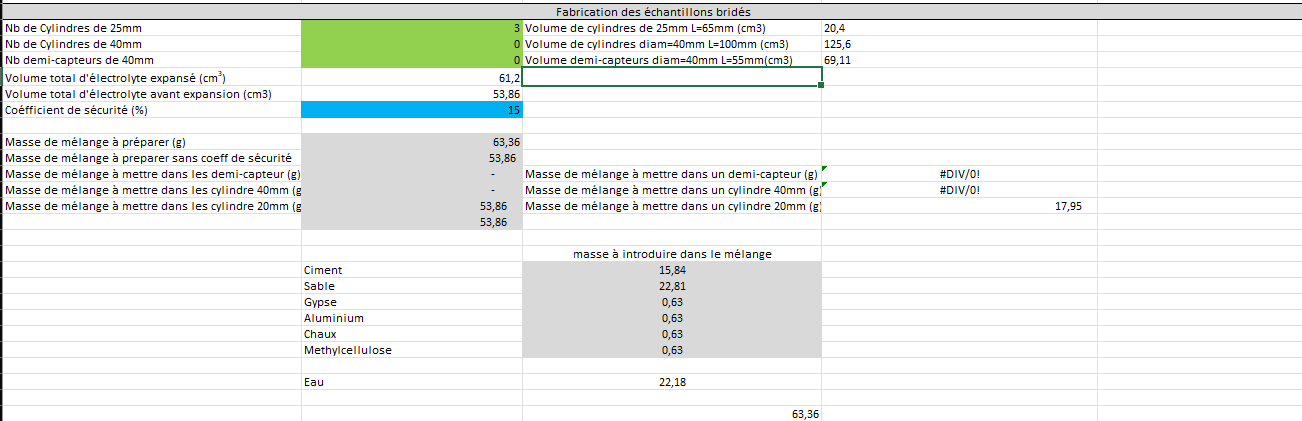
[picture p204: figure]
