djibril99/stageIRD/images/TEST_Filtre_mediant_passBas/donnee filtrer-donnerBrute_Mediane-PasseBas-avec-EAU.png

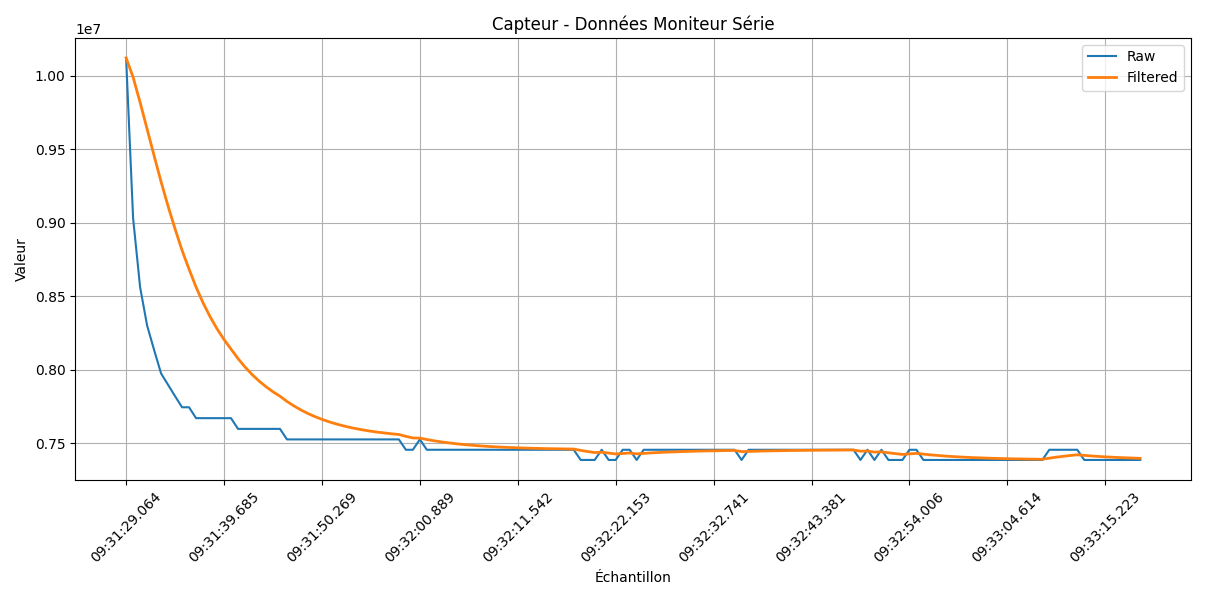
images/TEST_Filtre_mediant_passBas/donnee filtrer-donnerBrute_Mediane-PasseBas-avec-EAU.png
