djibril99/stageIRD/images/TEST_Filtre_mediant_passBas/donnee filtrer-donnerBrute_Mediane-PasseBas.png

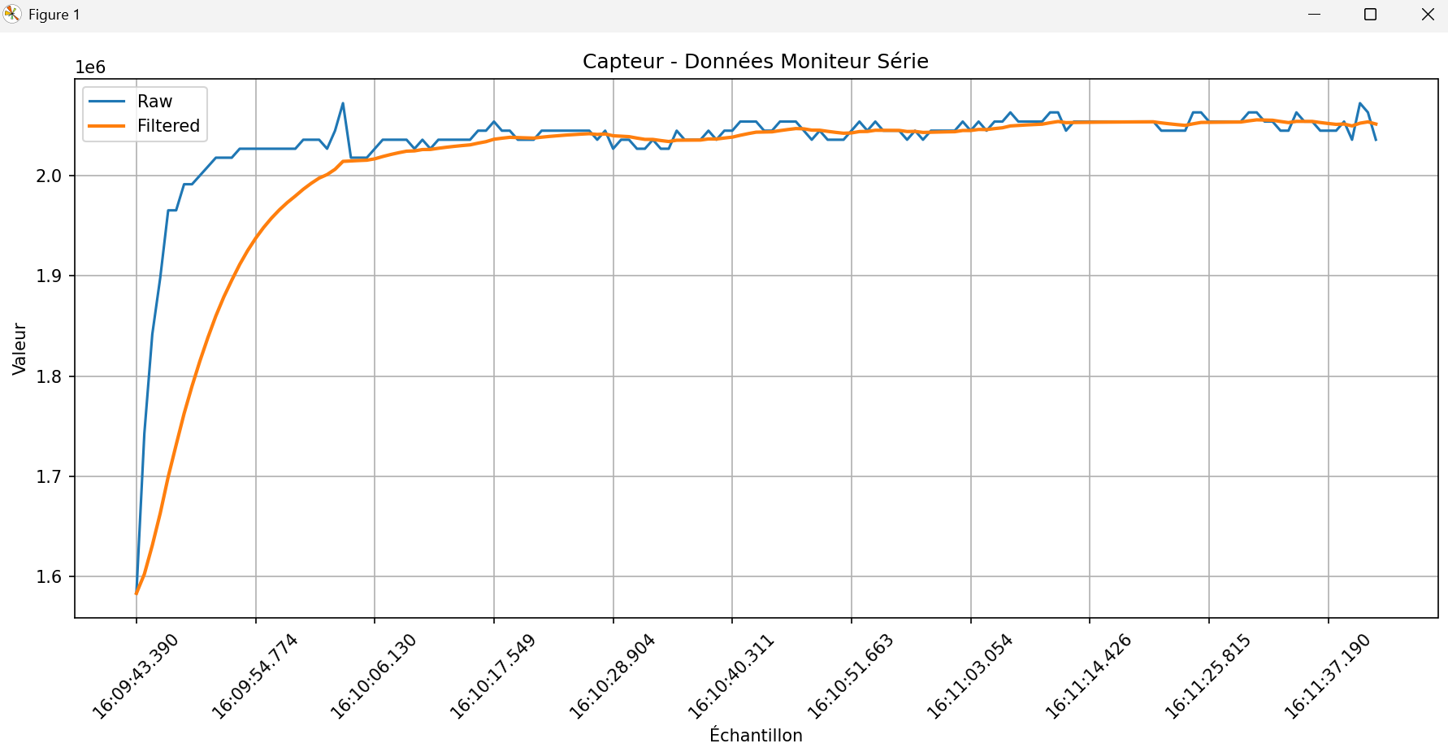
images/TEST_Filtre_mediant_passBas/donnee filtrer-donnerBrute_Mediane-PasseBas.png
