djibril99/stageIRD/images/TEST_Filtre_mediant_passBas/Figure_1.png

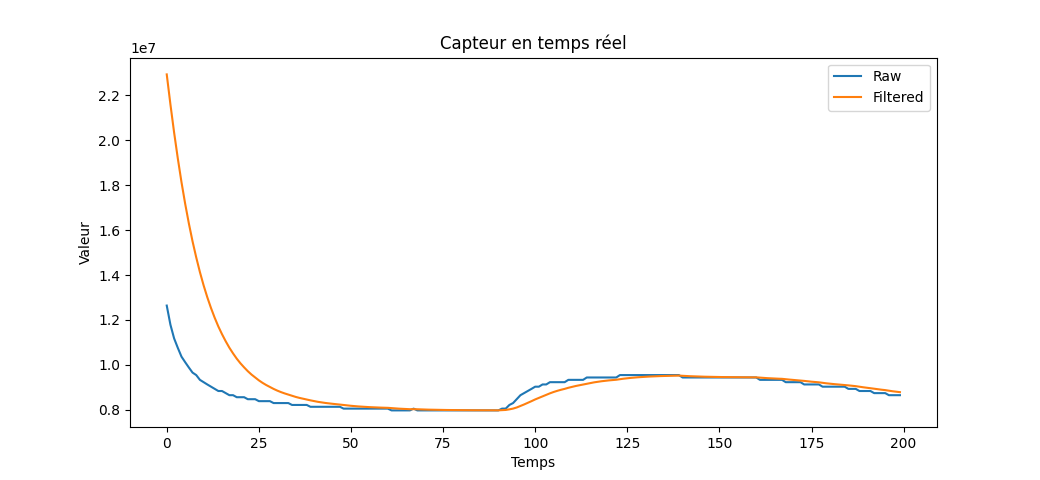
images/TEST_Filtre_mediant_passBas/Figure_1.png
