djibril99/stageIRD/images/TEST_Filtre_mediant_passBas/roleFiltre.png

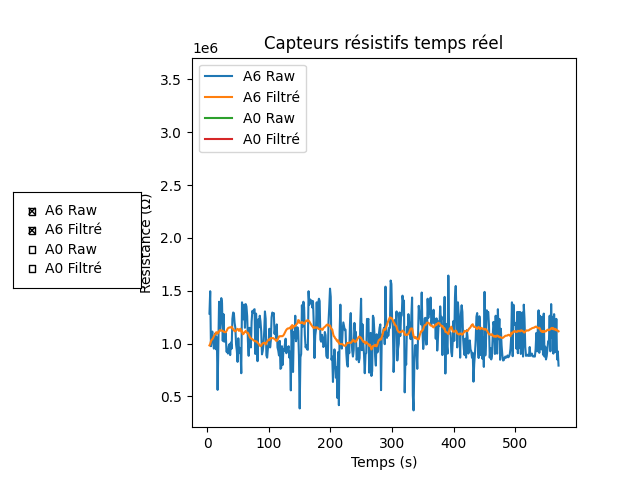
images/TEST_Filtre_mediant_passBas/roleFiltre.png
