djibril99/stageIRD/images/TEST_Filtre_mediant_passBas/variation importante.png

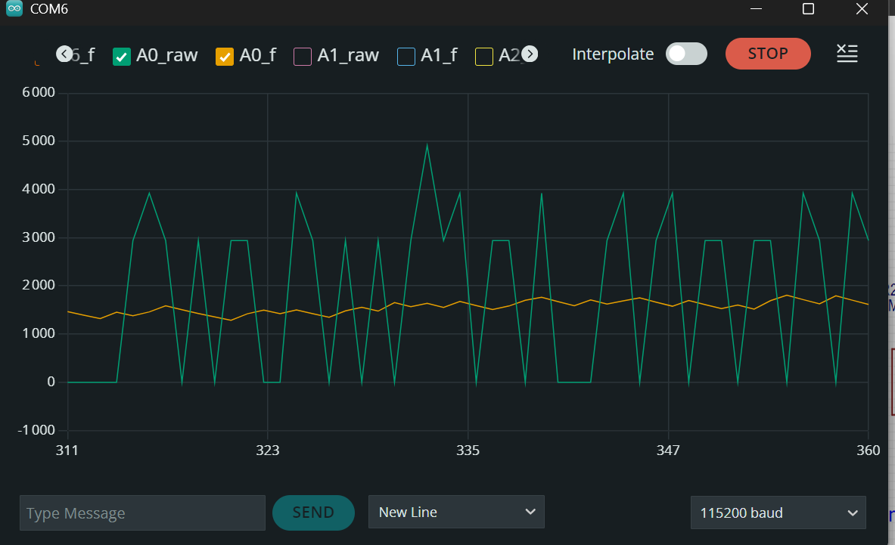
images/TEST_Filtre_mediant_passBas/variation importante.png
