djibril99/stageIRD/Documents/RE_ Suite Point_ Lancement stage djibril/Urbasence.kicad_pcb

## KiCad design Documents/RE_ Suite Point_ Lancement stage djibril/Urbasence.kicad_pcb (2026-06-10)

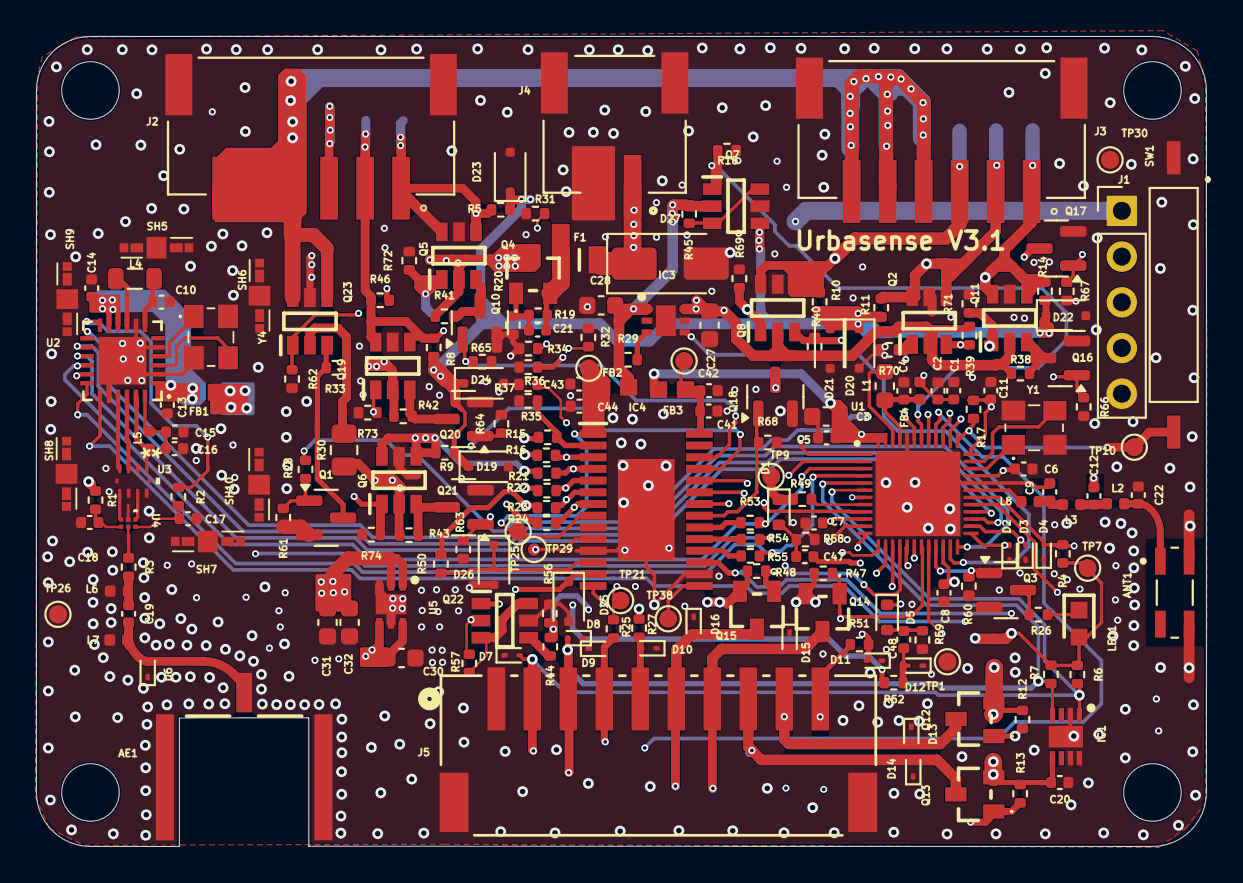
[picture p241: board Urbasence.kicad_pcb from above]

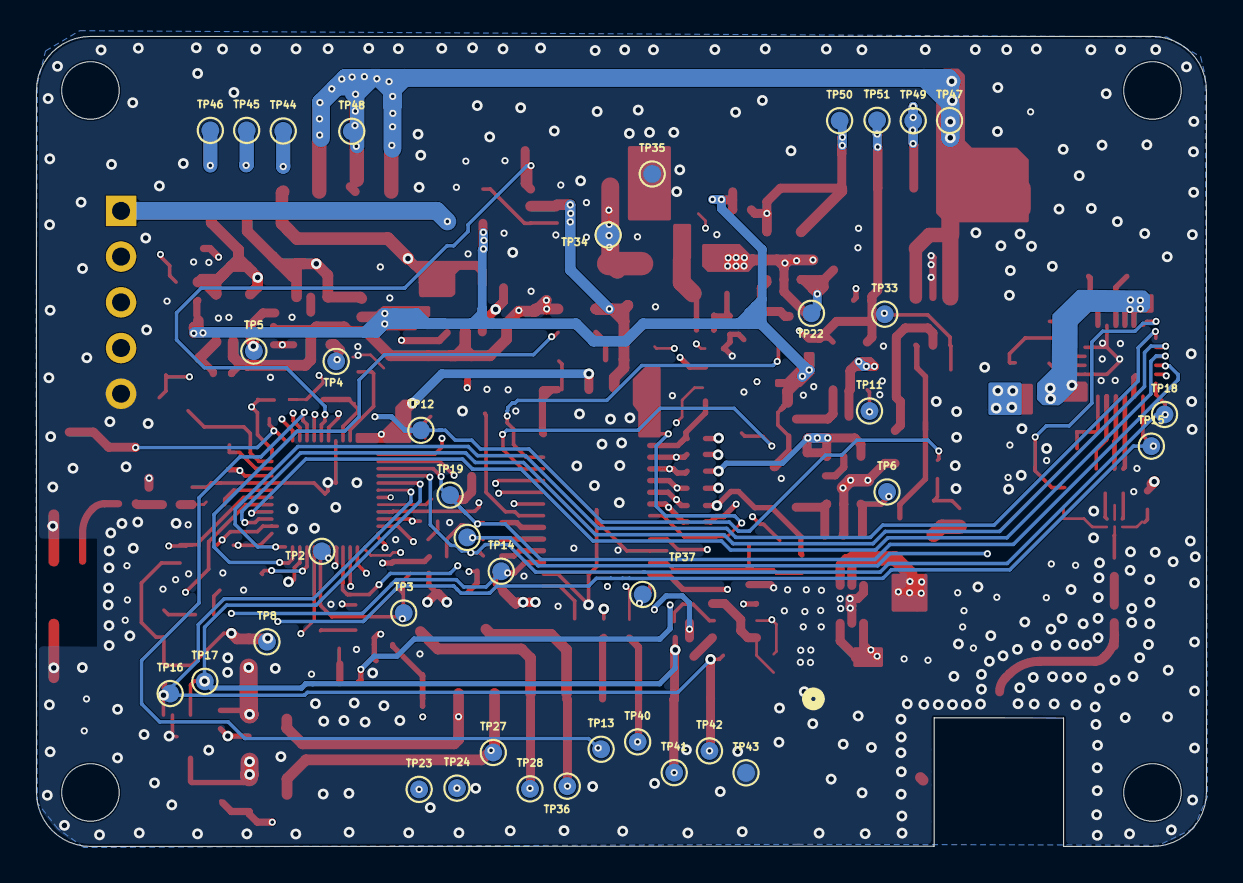
[picture p242: board Urbasence.kicad_pcb from below]

Board: 4 copper layers, 65.0 x 45.0 mm, 246 parts (38 on the bottom side), 124 nets.

Parts:
AE1: 60312202114307
ANT1: 2450AT42E0100E; XDCR_2450AT42E0100E
C1, C4, C41, C44: 2.2uF; C_0402_1005Metric
C2, C6: 10nF; C_0402_1005Metric
C3, C28, C31, C32: 10uF; C_0603_1608Metric
C5, C7, C8, C11, C14, C20, C42, C43: 100nF; C_0402_1005Metric
C9: 1.5pF; C_0402_1005Metric
C10: 470nF; C_0402_1005Metric
C12: 2pF; C_0402_1005Metric
C13, C21, C47, C48: 1uF; C_0402_1005Metric
C15: 47nF; C_0402_1005Metric
C16: 47pF; C_0402_1005Metric
C17, C18: 1nF; C_0402_1005Metric
C19: 4.7pF; C_0402_1005Metric
C22: 0.3pF; C_0402_1005Metric
C27: 1uF; C_0603_1608Metric
C30: 4.7uF/25V; C_0603_1608Metric
D1, D5: 1N4148WT; D_SOD-523
D2, D3, D4, D7, D8, D9, D10, D11, D12, D13, D14, D15, D16: ESD9B3.3ST5G; D_SOD-923
D6: ESD9B5.0ST5G; D_SOD-923
D19, D20, D21, D22, D23, D24, D25, D26: MM3Z5V1T1G; D_SOD-323F
D27: SMAJ9.0A; D_SMA
F1: MF-PSHT050KX-2; FUSE 500mA 0ZCK0050FF2E
FB1, FB2, FB3: 3A; FERIT_BLM18_0603_MUR
FB4: 3A; L_0402_1005Metric
H1, H2, H3, H4: MountingHole_Pad; MountingHole_3.2mm_M3
IC1: STS35-DIS; STS35-SON50P250X250X100-9N-D
IC3: TPS7A2650DRVR; TPS7A26-SON65P200X200X80-7N
IC4: LMP90100MHX_NOPB; LMP90100-SOP65P640X110-29N
J1: Flashing; PinHeader_1x05_P2.54mm_Vertical
J2, J3: Conn_01x06; JST_S6B-PH-SM4-TB_LF__SN_
J4: Conn_01x02; JST_S2B-PH-SM4-TB_LF__SN_
J5: Conn_01x10; CONN_S10B-PH-SM4-TBLFSN_JST
L1: 4.7uH; L_0603_1608Metric
L2, L3: 3.5nH; L_0402_1005Metric
L4: 15uH; L_0805_2012Metric
L5: 47nH; L_0402_1005Metric
L6, L7: 150nH; L_0402_1005Metric
L8: 2.7nH; L_0402_1005Metric
LED1: LED_0603
Q1, Q3, Q10, Q16, Q17, Q18, Q20, Q21: 2N7002; SOT-23
Q2, Q5, Q6, Q7, Q8, Q11, Q19, Q22, Q23: DMC2053-SOP95P280X100-6N
Q4, Q12, Q13, Q14, Q15: SSM3J372R,LF; SSM3J372RLF
R1, R2: 100R; R_0402_1005Metric
R3, R28, R49, R53, R54, R55: 0; R_0402_1005Metric
R4, R12, R13, R17, R18, R19, R29, R47, R48, R58, R59, R60, R61, R62, R63, R64, R65, R66, R67, R68, R69, R70, R71, R72, R73, R74: 10k; R_0402_1005Metric
R5, R8, R9, R10, R11, R14: 10k/0.5%; R_0402_1005Metric
R6, R7: 4.7k; R_0402_1005Metric
R15, R16, R21, R22, R23, R24: 1k/0.5%; R_0402_1005Metric
R20: 20k; R_0402_1005Metric
R25, R27: 22; R_0402_1005Metric
R26: 470R; R_0402_1005Metric
R30: 0; R_0805_2012Metric
R31, R32, R34, R35, R36, R37: 47k; R_0402_1005Metric
R33, R38, R39, R40, R41, R42, R43, R45: 100k; R_0402_1005Metric
R44: 27k; R_0402_1005Metric
R46, R50, R51, R52: 1k; R_0402_1005Metric
R56: 10K; R_0402_1005Metric
R57: 100K; R_0402_1005Metric
SH5, SH6, SH7, SH8, SH9, SH10: S0951-46R; S095146R
SW1: CT10-1530-G1
TP1, TP2, TP3, TP4, TP5, TP6, TP7, TP8, TP9, TP10, TP11, TP12, TP13, TP14, TP15, TP16, TP17, TP18, TP19, TP20, TP21, TP22, TP23, TP24, TP25, TP26, TP27, TP28, TP29, TP30, TP31, TP32, TP33, TP34, TP35, TP36, TP37, TP38, TP40, TP41, TP42, TP43, TP44, TP45, TP46, TP47, TP48, TP49, TP50, TP51: TestPoint; TestPoint_Pad_D1.0mm
U1: NRF54l15-QFAA; nRF52840-QFAA-F-R7
U2: SX1262IMLTRT
U3: 0900FM15K0039E; 0900FM15D0039E_JOT
U4: BGS12WN6E6327XTSA1; PG-TSNP-6-10_INF
U5: TLV76733DRVT; SON65P200X200X80-7N
Y1, Y4: 32MHz; ECS2501033BCKMTR

Connections:
3V3: C3.2, C5.2, C7.2, C8.2, C11.2, C20.2, C31.2, C32.2, FB1.2, FB3.1, IC1.5 (VDD), J1.1, LED1.2, Q12.2 (S), Q13.2 (S), Q14.2 (S), Q15.2 (S), R4.1, R6.1, R7.1, R12.1, R13.1, R17.1, R47.1, R48.1, TP7.1, TP8.1, U1.10 (VDD), U1.22 (VDD), U1.36 (VDD), U1.47 (Vdd), U1.48 (Vdd), U5.1 (OUT), U5.2 (SNS)
5V: C28.2, FB2.2, IC3.1 (OUT), Q7.2 (S2), R29.1, R45.1
/LMP90100/COM: J2.4, J2.5, J2.6, J3.4, J3.5, J3.6, Q23.4 (D2), Q23.6 (D2), TP47.1, TP48.1
/LMP90100/WM1/EV1: J2.1, Q5.4 (D2), Q5.6 (D2), R5.2, R15.1, R52.1, TP50.1
/LMP90100/WM2/EV2: J2.2, Q19.4 (D2), Q19.6 (D2), R8.2, R16.1, R46.1, TP51.1
/LMP90100/WM3/EV3: J2.3, Q6.4 (D2), Q6.6 (D2), R9.2, R21.1, TP49.1
/LMP90100/WM4/EV4: J3.1, Q11.4 (D2), Q11.6 (D2), R14.2, R22.1, TP46.1
/LMP90100/WM5/EV5: J3.2, Q2.4 (D2), Q2.6 (D2), R11.2, R23.1, R50.1, TP45.1
/LMP90100/WM6/EV6: J3.3, Q8.4 (D2), Q8.6 (D2), R10.2, R24.1, TP44.1
/nRF54L15/TOR/Counter1: D1.1 (K), R49.2, TP9.1
BAT_CHECK: IC4.10 (VIN6/VREFP2), R44.2, R56.1, TP29.1
BUSY: U1.27 (P0.02), U2.14 (BUSY)
CLK: R55.2, TP18.1, U1.4 (P1.03/NFC2), U2.18 (SCK)
CS1: TP15.1, U1.38 (P1.10), U2.19 (NSS)
CS2: IC4.17 (CSB), TP14.1, U1.39 (P1.11/AIN4/CK)
Control_COM: Q23.1 (G1), R62.1, TP33.1, U1.11 (P2.00)
Control_COM_Hi: R28.2, TP12.1, U1.41 (P1.13/AIN6)
Control_WM1: Q5.1 (G1), R72.1, TP22.1, U1.12 (P2.01/CK)
Control_WM1_Hi: IC4.26 (D5), Q10.1 (G), R65.1
Control_WM2: Q19.1 (G1), R73.1, TP11.1, U1.13 (P2.02)
Control_WM2_Hi: IC4.25 (D4), Q20.1 (G), R64.1
Control_WM3: Q6.1 (G1), R74.1, TP6.1, U1.14 (P2.03)
Control_WM3_Hi: IC4.24 (D3), Q21.1 (G), R63.1
Control_WM4: Q11.1 (G1), R71.1, TP5.1, U1.15 (P2.04)
Control_WM4_Hi: IC4.23 (D2), Q16.1 (G), R66.1
Control_WM5: Q2.1 (G1), R70.1, TP4.1, U1.16 (P2.05)
Control_WM5_Hi: IC4.22 (D1), Q17.1 (G), R67.1
Control_WM6: Q8.1 (G1), R69.1, U1.17 (P2.06/CK)
Control_WM6_Hi: IC4.21 (D0), Q18.1 (G), R68.1
Controled_5V: Q7.1 (G1), R18.1, U1.42 (P1.14/AIN7)
DIO1: U1.24 (P0.01), U2.13 (DIO1)
EN_5V: IC3.4 (EN), U1.23 (P0.00)
EN_BAT_CHECK: Q22.1 (G1), U1.9 (P1.08/EXTREF/CLK16M/ck)
ETX1: Q15.1 (G), R48.2, TP2.1, U1.18 (P2.07/SWO)
ETX2: Q14.1 (G), R47.2, TP3.1, U1.19 (P2.08)
ETX3: Q13.1 (G), R13.2, U1.20 (P2.09)
ETX4: Q12.1 (G), R12.2, U1.29 (P0.04CK)
GND: AE1.2, AE1.3, ANT1.3, ANT1.4, C1.1, C2.1, C3.1, C4.1, C5.1, C6.1, C7.1, C8.1, C9.1, C10.1, C11.1, C12.1, C13.1, C14.1, C15.2, C16.2, C17.2, C18.2, C20.1, C22.1, C27.1, C28.1, C30.1, C31.1, C32.1, C41.1, C42.1, C43.1, C44.1, D2.1 (A1), D3.1 (A1), D4.1 (A1), D6.1 (A1), D7.1 (A1), D8.1 (A1), D9.1 (A1), D10.1 (A1), D11.1 (A1), D12.1 (A1), D13.1 (A1), D14.1 (A1), D15.1 (A1), D16.1 (A1), D19.2 (A), D20.2 (A), D21.2 (A), D22.2 (A), D23.2 (A), D24.2 (A), D25.2 (A), D26.2 (A), D27.2 (A2), IC1.2 (ADDR), IC1.7 (R), IC1.8 (VSS), IC1.9 (GND), IC3.5 (GND), IC3.7 (EP), IC4.9 (VREFN1), IC4.11 (VIN7/VREFN2), IC4.16 (GND), IC4.29 (EP), J1.5, J2.S1, J2.S2, J3.S1, J3.S2, J4.2, J4.S2, J4.g, J5.1, J5.11, J5.12, L6.1, L7.1, Q1.2 (S), Q2.5 (S1), Q3.2 (S), Q5.5 (S1), Q6.5 (S1), Q7.5 (S1), Q8.5 (S1), Q10.2 (S), Q11.5 (S1), Q16.2 (S), Q17.2 (S), Q18.2 (S), Q19.5 (S1), Q20.2 (S), Q21.2 (S), Q22.5 (S1), Q23.5 (S1), R18.2, R20.2, R31.1, R32.1, R34.2, R35.1, R36.1, R37.1, R56.2, R58.2, R59.2, R60.2, R61.2, R62.2, R63.2, R64.2, R65.2, R66.2, R67.2, R68.2, R69.2, R70.2, R71.2, R72.2, R73.2, R74.2, SH5.1, SH5.2, SH5.3, SH5.4, SH5.5, SH6.1, SH6.2, SH6.3, SH6.4, SH6.5, SH7.1, SH7.2, SH7.3, SH7.4, SH7.5, SH8.1, SH8.2, SH8.3, SH8.4, SH8.5, SH9.1, SH9.2, SH9.3, SH9.4, SH9.5, SH10.1, SH10.2, SH10.3, SH10.4, SH10.5, SW1.1, TP1.1, TP26.1, TP30.1, TP35.1, TP43.1, U1.32 (Vss_PA), U1.44 (Vss), U1.49 (Vss), U2.2 (GND), U2.5 (GND), U2.8 (GND), U2.20 (GND), U2.25 (GND), U3.2 (GND), U3.5 (GND), U3.7 (GND), U3.9 (GND), U3.10 (GND), U4.2 (GND), U5.3 (GND_1), U5.5 (GND_2), U5.7 (EP), Y1.2, Y1.4, Y4.2, Y4.4
I2C_SCK: D8.2 (A2), IC1.4 (SCL), J5.3, R7.2, TP17.1, TP41.1, U1.5 (P1.04/AIN0)
I2C_SDA: D7.2 (A2), IC1.1 (SDA), J5.2, R6.2, TP16.1, TP42.1, U1.6 (P1.05/AIN1)
L_RESET: U1.28 (P0.03CK), U2.15 (NRESET)
MISO: R53.2, TP19.1, U1.3 (P1.02/NFC1), U2.16 (MISO)
MOSI: R54.2, TP20.1, U1.2 (P1.01/XL2), U2.17 (MOSI)
unnamed: ANT1.1, C22.2, L2.2
unnamed: C9.2, L3.1, L8.2
unnamed: C12.2, L2.1, L3.2
unnamed: C19.1, L6.2, R3.2
unnamed: C47.1, D1.2 (A), R58.1
unnamed: C48.1, D5.2 (A), R59.1
unnamed: AE1.1, C19.2, D6.2 (A2), L7.2
unnamed: D9.2 (A2), J5.4, R25.1, TP40.1
unnamed: D10.2 (A2), J5.5, R27.1
unnamed: C47.2, D11.2 (A2), R51.2
unnamed: C48.2, D12.2 (A2), R52.2
unnamed: D13.2 (A2), J5.9, Q12.3 (D), TP24.1
unnamed: D14.2 (A2), J5.8, Q13.3 (D), TP27.1
unnamed: D15.2 (A2), J5.7, Q14.3 (D), TP28.1
unnamed: D16.2 (A2), J5.6, Q15.3 (D), TP36.1
unnamed: D19.1 (K), D20.1 (K), D21.1 (K), D22.1 (K), D23.1 (K), D24.1 (K), Q7.4 (D2), R5.1, R8.1, R9.1, R10.1, R11.1, R14.1
unnamed: D25.1 (K), IC4.13 (IB1), R46.2
unnamed: D26.1 (K), IC4.12 (IB2), R50.2
unnamed: D27.1 (A1), F1.1, J4.1, TP34.1
unnamed: IC3.3 (PG), R29.2
unnamed: IC4.18 (SCLK), R55.1
unnamed: IC4.19 (SDI), R54.1
unnamed: IC4.20 (SDO/DRDYB), R53.1
unnamed: C43.2, C44.2, FB2.1, IC4.1 (VA), IC4.8 (VREFP1), TP25.1, TP32.1
unnamed: IC4.2 (VIN0), R15.2, R35.2
unnamed: IC4.3 (VIN1), R16.2, R37.2
unnamed: IC4.4 (VIN2), R21.2, R36.2
unnamed: IC4.5 (VIN3), R22.2, R34.1
unnamed: IC4.6 (VIN4), R23.2, R32.2
unnamed: IC4.7 (VIN5), R24.2, R31.2
unnamed: C41.2, C42.2, FB3.2, IC4.28 (VIO), TP31.1
unnamed: IC4.15 (XIN/CLK), TP38.1
unnamed: IC4.14 (XOUT), TP37.1
unnamed: J5.10, R51.1, TP23.1
unnamed: LED1.1, R26.1
unnamed: Q1.3 (D), Q23.3 (G2), R33.2
unnamed: Q1.1 (G), R28.1, R61.1
unnamed: Q3.3 (D), R26.2
unnamed: Q3.1 (G), R60.1, U1.21 (P2.10)
unnamed: C21.1, Q4.1 (G), R19.2, R20.1
unnamed: C21.2, F1.2, Q4.2 (S), R19.1
unnamed: Q7.3 (G2), Q7.6 (D2), R45.2
unnamed: Q5.3 (G2), Q10.3 (D), R41.2
unnamed: Q11.3 (G2), Q16.3 (D), R38.2
unnamed: Q2.3 (G2), Q17.3 (D), R39.2
unnamed: Q8.3 (G2), Q18.3 (D), R40.2
unnamed: Q19.3 (G2), Q20.3 (D), R42.2
unnamed: Q6.3 (G2), Q21.3 (D), R43.2
unnamed: Q22.3 (G2), Q22.6 (D2), R57.1
unnamed: Q22.4 (D2), R44.1
unnamed: Q23.2 (S2), R30.2, R33.1
unnamed: L8.1, U1.31 (Ant)
unnamed: L1.2, U1.46 (DCC)
unnamed: C1.2, C2.2, C6.2, FB4.2, U1.33 (DECRF), U1.43 (DECA)
unnamed: C4.2, FB4.1, L1.1, U1.45 (DECD)
unnamed: U1.34 (XC1), Y1.1
unnamed: U1.35 (XC2), Y1.3
unnamed: R49.1, U1.8 (P1.07/AIN3)
unnamed: R17.2, SW1.2, TP10.1, U1.37 (P1.09)
unnamed: L4.2, U2.9 (DCC_SW)
unnamed: R2.2, U2.12 (DIO2)
unnamed: U2.22 (RFI_N), U3.3 (RFI_N)
unnamed: U2.21 (RFI_P), U3.4 (RFI_P)
unnamed: L5.2, U2.23 (RFO), U3.1 (RFO)
unnamed: C10.2, L4.1, U2.7 (VREG)
unnamed: C15.1, C16.1, L5.1, U2.24 (VR_PA)
unnamed: U2.3 (XTA), Y4.3
unnamed: U2.4 (XTB), Y4.1
unnamed: U3.6 (SW_RFI), U4.3 (RF1)
unnamed: U3.8 (SW_RFO), U4.1 (RF2)
unnamed: C17.1, R2.1, U4.6 (CTRL)
unnamed: R3.1, U4.5 (RFIN)
unnamed: C18.1, R1.2, U4.4 (VDD)
RESET: D4.2 (A2), J1.4, R4.2, U1.30 (RESET)
RXD: R25.2, TP21.1, U1.1 (P1.00/XL1)
SWDCLK: D3.2 (A2), J1.3, U1.26 (SWDCLK)
SWDIO: D2.2 (A2), J1.2, U1.25 (SWDIO)
TOR/Counter2: D5.1 (K), U1.7 (P1.06/AIN2)
TXD: R27.2, TP13.1, U1.40 (P1.12/AIN5/CK)
V_RADIO: C13.2, C14.2, FB1.1, R1.1, U2.1 (VDD_IN), U2.10 (VBAT), U2.11 (VBAT_IO)
V_bat: C27.2, C30.2, IC3.6 (IN), Q2.2 (S2), Q4.3 (D), Q5.2 (S2), Q6.2 (S2), Q8.2 (S2), Q11.2 (S2), Q19.2 (S2), Q22.2 (S2), R30.1, R38.1, R39.1, R40.1, R41.1, R42.1, R43.1, R57.2, U5.4 (EN), U5.6 (IN)
